Aottens/PTZ-DriverBoard/hardware/fab/jlc_pins.md

| LCSC | Part | First reference | JLC's pin: name -> net on the board |
| --- | --- | --- | --- |
| C7171 | 10 µF 16 V | C111 | 1: 1 -> +3V3, 2: 2 -> GND |
| C19077573 | SMBJ18A | D101 | 1: C -> VM, 2: A -> GND |
| C8678 | SS34 | D102 | 1: K -> +5V, 2: A -> +5V_REG |
| C8598 | B5819W | D201 | 1: - -> EN, 2: + -> PERIPH_RST_N |
| C2500 | BAV99 | D302 | 1: 1 -> GND, 2: 2 -> +3V3, 3: 3 -> HOME1 |
| C400894 | AOD4185 | Q101 | 1: G -> RP_GATE, 2: D -> VIN_RAW, 3: S -> VIN |
| C20917 | AO3400A | Q801 | 1: G -> FAN_G, 2: S -> GND, 3: D -> FAN_N |
| C2892547 | NTC 10k | RT801 | 1: 1 -> NTC_SENSE, 2: 2 -> GND |
| C6186 | AMS1117-3.3 | U102 | 1: GND -> GND, 2: VOUT -> +3V3, 3: VIN -> +5V, 4: VOUT -> not connected |
| C7420376 | SRV05-4 | U301 | 1: 1 -> SNS1_SDA, 2: 2 -> GND, 3: 3 -> SNS1_SCL, 4: 4 -> unconnected-(U301-IO3-Pad4), 5: 5 -> V_SNS, 6: 6 -> unconnected-(U301-IO4-Pad6) |
| C130026 | TCA9548A | U701 | 1: A0 -> GND, 2: A1 -> GND, 3: RESET# -> PERIPH_RST_N, 4: SD0 -> MUX1_SDA, 5: SC0 -> MUX1_SCL, 6: SD1 -> MUX2_SDA, 7: SC1 -> MUX2_SCL, 8: SD2 -> MUX3_SDA, 9: SC2 -> MUX3_SCL, 10: SD3 -> MUX4_SDA, 11: SC3 -> MUX4_SCL, 12: GND -> GND, 13: SD4 -> MUX5_SDA, 14: SC4 -> MUX5_SCL, 15: SD5 -> unconnected-(U701-SD5-Pad15), 16: SC5 -> unconnected-(U701-SC5-Pad16), 17: SD6 -> unconnected-(U701-SD6-Pad17), 18: SC6 -> unconnected-(U701-SC6-Pad18), 19: SD7 -> unconnected-(U701-SD7-Pad19), 20: SC7 -> unconnected-(U701-SC7-Pad20), 21: A2 -> GND, 22: SCL -> I2C_SCL, 23: SDA -> I2C_SDA, 24: VCC -> +3V3 |
