Aottens/PTZ-DriverBoard/DECISIONS.md

# PTZ driver board — Decision Log

Append-only. Newest at top. Each entry: date, decision, alternatives, why, reversal trigger.

---

## 2026-11-12 — Rev B: what was done with the third blind review

The board was routed again after the second review, so a fresh reviewer saw the board as it is ordered
(`hardware/review/BLIND_REVIEW_3.md`). Verdict: order. No KRITIEK finding, one BELANGRIJK, nine KLEIN; nothing on
the board or in the JLC files changes. Six findings repeat ones accepted on 2026-11-11 (the RJ45 jack and the
wall, the height above the heat sinks, the headroom of `+3V3`, the shared reset, the three rails without a test
point, the DevKit version). Two are new and accepted:
- **SLEEPN of the TMC2240 above VS + 0.3 V on USB alone (K6).** The BIGTREETECH module ties SLEEPN to VCC_IO
  through 4.7 kΩ, and the board gives the modules 3.3 V on USB while `VM` is off. The calculation: at most
  (3.3 − 0.6) V / 4.7 kΩ = 0.6 mA into the pin per module. The limit is the module maker's to keep and the
  resistor bounds the current; the board cannot change it without giving up logic on USB, which POW-05 asks.
  What follows for firmware: four modules can feed `VM` about 2.3 mA against the 110 kΩ of the sense divider,
  so `VM` may read up to about 2.7 V with no supply. Bring-up 7.9 measures it.
- **No TVS array on the home inputs (K8).** 10 kΩ in series and a BAV99 to ground and `+3V3` keep the MCU pin
  within its limits with 17 V on the wire (1.3 mA, by calculation), which is what ENC-03 asks. A hard discharge
  lands on a 0603 resistor.
One finding is answered by calculation: the reviewer suspected that JLC's placement point of an asymmetric part
differs from the point in the CPL (K5). `make_jlc.py` writes the origin of JLC's own footprint, and for the
TO-252, both SOT-223 and the SOT-23 parts that origin is the middle of JLC's pads, within 0.1 mm of the middle of
ours. The preview stays the check.
*Alternatives:* a diode from `VM` to each socket's SLEEPN, which is not on the StepStick pins; a spare channel of
each SRV05-4 on the home input, which is a board change and a new routing for a part the spec does not ask.
*Reversal trigger:* bring-up 7.9 reads `VM` above 3 V on USB alone, or a home input fails after a discharge:
then the next revision takes the SRV05-4's spare channels, or a GPIO on the reset line (K3).

## 2026-11-11 — Rev B: the loose parts come from Reichelt, and the regulator is the Traco again

The owner's LCSC cart showed about €22 of import charges on the $22.51 of loose parts. Since 1 July 2026 a parcel
up to €150 from outside the EU pays €3 of duty per kind of product (LCSC counts its first-level categories), with
handling on top; the quantity does not count, the number of kinds does. So the list moves inside the EU.
Reichelt has 17 of its lines, read on its Dutch pages: genuine JST headers, housings and contacts for VH, XH and
PH, Littelfuse TR5 fuses and holders, the capacitors, a pin header and the Traco TSR 1-2450, together €22.25 with
VAT and €6.95 for DPD. The socket strips come as four female headers 1×40 with the modules from TinyTronics.
This overturns the entry below, of the same day: its reason was DigiKey's €18 of shipping for one regulator, and
at Reichelt the Traco (€6.97) comes with the rest.
*Alternatives:* LCSC, cheaper per part but about €25 of goods with VAT, shipping and the €22; TME, whose product
pages could not be read (shipping €7.14); TinyTronics alone, which has no VH connector, no TR5 fuse and no 1 A
regulator in this form.
*What is given up:* a stock check by script, since Reichelt's pages refuse one. The supply connector is the
B2P-VH-B, the same header in PBT: KiCad's footprints for the two have the same pads.
*Also changed:* the estimate of the JLC order counts the same charge, €5 to €10, and is now €68 to €90.
*Reversal trigger:* the charge goes, or an order grows so large that LCSC's prices outweigh it.

---

## 2026-11-11 — Rev B: the 5 V regulator on the shopping list is YLPTEC's K7805-1000R3

The owner asked which shop is cheapest for the loose parts. The parts cost little everywhere; what counts is the
number of parcels. The Traco TSR 1-2450 was the only reason for a DigiKey order: €5.57 + VAT, and €18 shipping
below €50. LCSC had no Traco, but 11 005 of YLPTEC's K7805-1000R3 (C2992391) at $2.38, which rides in the LCSC
order the owner places anyway. Its data sheet (V1.00, 06/2013, listed in `hardware/datasheets/README.md`) gives pins 1 = in,
2 = ground, 3 = out, 8 to 36 V in, 1 A, 680 µF of capacitive load and a body of 11.5 × 7.55 × 10.2 mm: what POW-07
and the footprint ask. The list orders two, one as a spare.
*Alternatives:* the Traco at Reichelt (€7.22) or RS (€7.08), each a parcel of its own with shipping that was not
found on an official page; TinyTronics' Hi-Link K7805-500R3, which gives 0.5 A where the budget is 0.9 A.
*What is given up:* a certified maker. The sheet is three pages, with no absolute maximum input voltage, no
start-up behaviour and no word on back-feed (D102 covers that) or over-temperature. Nothing is measured.
*Reversal trigger:* the 5 V rail fails section 1 of `tests/hardware/bringup-rev-b.md`, or dips when the modules go
in; then a Traco TSR 1-2450 or a Mornsun K7805-1000R3 goes into the same holes.

---

## 2026-11-11 — Rev B: what was done with the blind review

The first review is `hardware/review/BLIND_REVIEW.md`: no KRITIEK finding, three BELANGRIJK, all three fixed.
`hardware/review/HANDLED.md` lists every finding, the small ones too, and the second review of the changed board.

**B1, parts under the soldered-in Ethernet module: fixed.** Nothing stands under it now; `check_board.py` checks it.

**B2, the fan output on VM was not short-proof: fixed by taking the option away.** The fan output is 5 V only. A
fan for the supply voltage would need a fuse of its own, and the PRD asks for one fan output, not for two voltages.
*Reversal trigger:* a 5 V fan cannot cool the four drivers on the rig; then a later revision gets a fused 12 V output.

**B3, the 5 V module and what it must charge: fixed, and the choice of module narrowed.** The board's own
capacitance on the logic rails went from about 320 µF to 113 µF; with the plugged-in modules the estimate is about
230 µF. The Traco TSR 1-2450 (470 µF) and the Mornsun K7805-1000R3 (680 µF) take that; the RECOM R-78E5.0-1.0
(220 µF) does not and is ruled out in the spec, in `ASSEMBLY.md` and on the silkscreen. The AMS1117 regulators keep
30 µF of tantalum at their outputs, above the 22 µF their data sheet asks for.

**The second review, of the board after those fixes** (`BLIND_REVIEW_2.md`): no KRITIEK, three BELANGRIJK.
- *B1, the ground of the motor half hung on 4 mm of copper: fixed.* The signals between the MCU module and the
  sockets cut both pours across the board. Ground is now laid as tracks before routing, on the bottom: a spine
  north of the MCU module's pin row from that module's ground pins to the supply connector, and four bridges north
  to ground pins of the sockets. `tools/groundcut.py` gives 14.0 mm of copper to the supply connector and 10.0 mm
  to the MCU module, from 4.2 mm for both; BRD-13 asks 8 and `check_board.py` checks it. It is a measure of
  geometry, not of noise: whether SPI is clean beside running motors is bring-up step 7.6.
- *B2, no surge clamp on the logic branch with the motor fuse out: fixed.* A second SMBJ18A (D103) on `VIN_L`, and
  the gate divider at half the input instead of 0.6. *Alternative:* moving the one TVS in front of both fuses, which
  leaves a failed TVS without a fuse.
- *B3, 26 to 32 mm between the Ethernet jack and the wall: accepted.* The head does not exist; the base gets a hole
  in line with the jack or a coupler in the wall with a short lead (`hardware/ASSEMBLY.md`, RB-05). Turning the
  module a quarter would point the jack at the pan motor or at the drivers. *Reversal trigger:* the base's CAD
  model cannot give either.
The board changed after this second review and has had no third one: ERC, DRC, the netlist check and the ground
measurement are what cover those last changes.

**Accepted small findings, with the reason:**
- *K1, `+3V3` has about 1.25 V above the regulator where its data sheet asks 1.3 V at 0.8 A.* The load is 0.17 A,
  where the drop-out is about 1.1 V; the calculation leaves it in regulation. Bring-up steps 1.3, 3.2 and 6.1 measure
  it. *Reversal trigger:* `+3V3` under 3.2 V with the Ethernet module sending; then D102 becomes a part with a lower
  drop, or U102 a regulator with a lower drop-out in the same package.
- *K3, the TMC2240's DIAG0 is open drain by default.* Firmware sets `diag0_pushpull`; DRV-05 and bring-up 7.3 say so.
- *K6, no reset of the multiplexer apart from the MCU's.* No pin is left; firmware can clock a stuck sensor free.
- *K8, ground pins sit solid in the copper.* Thermal spokes left pins on a single spoke on this two-layer board;
  the owner solders with a second more heat.
- *K9 to K12, fit and edge distances:* stated in `ASSEMBLY.md` and in the pull request's flags.
- *K14, a shorted sensor cable restarts the MCU for as long as the short lasts.* Nothing is damaged, which is what
  POW-03 asks. A resettable fuse per port would be a fourth and fifth Extended line. *Reversal trigger:* a sensor
  cable that shorts in use.

---

## 2026-11-11 — Rev B: what the one-run build decided

Made by the Rev B build session (RB-02) inside the approved PRD; the owner sees them in the pull request. Each can
be undone on a next revision; none changes a requirement.

**The 5 V regulator, the two fuses and the four bulk capacitors are through-hole parts the owner solders.** JLC's
fee-free libraries (351 Basic, about 1 200 Preferred) hold no power inductor, fuse, electrolytic capacitor,
thermistor or P-channel power FET. A buck converter on the board would have been a fourth Extended line with a
layout nobody can measure in this build; a three-pin 5 V switching module in the 7805 pin order is certified by
its maker and is bought once instead of five times. *Alternative:* the XL1509 the PRD's part check names, with an
Extended inductor. *Reversal trigger:* the owner wants nothing to solder but connectors; then the buck comes back
at about €5 more per order.

**Three Extended lines, at the PRD's limit:** the I2C multiplexer, the reverse-polarity FET (AOD4185) and the
thermistor. Three small fee-free FETs in parallel were the first plan for reverse polarity; the calculation in
`hardware/calc/power.py` shows they do not survive the current a 5 A time-lag fuse lets through.

**The drivers and the Ethernet module share one SPI bus; every usable MCU pin is in use.** The N8 DevKitC the PRD
prefers is end of life at Espressif, and the N16R8 that shops sell needs GPIO35 to 37 for its memory. Without
those, without the pins of the module's own LED, USB and BOOT button, 28 pins are left, and 28 signals need one. A
bus of its own for Ethernet would have taken three more. So: one bus; a select line per driver socket, which is
also that socket's one-wire UART line when a TMC2209 is plugged in; three solder jumpers per socket that take a
TMC2209's MS1, MS2 and second UART pin off the bus; one shared stall and fault line through diodes (PRD DRV-04,
*proposal*); the multiplexer and the Ethernet module reset from the MCU's own reset line through a diode, because
no pin is left for it. *Reversal trigger:* firmware needs a spare pin, or Ethernet traffic disturbs the drivers on
the rig; then a later revision takes an I/O expander for the home inputs.

**The sensor ports have their own 3.3 V regulator, an ESD array each, and a jumper to 5 V.** A short on a sensor
cable then leaves the logic supply alone. The regulator is a second AMS1117, not a small 200 mA part: that one
limits a short to 100 mA but has no thermal shutdown, and 0.46 W in a SOT-23 is twice its rating. The home inputs
have a resistor and clamp instead of an ESD array, so they also survive a steady 17 V from a motor wire.

**The board is 100 × 80 mm on two layers, and the Ethernet module is soldered in.** That is the size the envelope
allows and JLC's cheapest size class. On ordinary sockets the Ethernet jack would stand 28 mm above the board,
over the 25 mm the envelope gives. The driver modules, on sockets with a 12 mm heat sink, reach 24.6 mm by
calculation: the base's height is the tightest number in the fit check, and the heat sink's height is an assumption.

**With USB plugged in while the supply is on, USB and the board's regulator share the logic load.** Both reach
`+5V` through a Schottky diode, so the higher of the two feeds it: a USB port may then see up to about 0.65 A, or
0.85 A with the fan running. Moving the fan to the regulator's side of its diode was not worth a new track
across the board. *Reversal trigger:* a USB port that cuts out during bench work with the supply on.

---

## 2026-11-11 — Rev B's PRD is approved; homing comes from the encoders

**Decision (owner, in chat):** The Rev B hardware and cost sections of `specs/PRD.md` are approved as written, the lines marked *(proposal)* included (gate 1). Pan and tilt need no homing move: their absolute encoders give the position at boot (FW-03). Zoom may home by stall against the ring's end, and a home input per axis stays as a fallback (ENC-03). How close a preset lands after a restart is measured on the rig (ENC-06, R-T2). Rev B is built by one Fable 5.2 session from `docs/prompts/fable-board-rev-b.md`, reusing the tools Rev A's session built.

**Alternatives considered:** stall homing on every axis, which by recollection is at best about one full step repeatable (0.24° at 7.5:1, against 0.005° in TGT-05) and runs the head into a stop in front of an audience; a home switch on every axis.

**Reasoning:** no move at power-up suits a theatre, and the encoders are on the board anyway. The open risk is the encoder's repeatability after a restart: one count is 0.088° on the AS5600 and 0.022° on the MT6701, and how far averaging helps depends on noise, which only the rig shows.

**Reversal trigger:** R-T2 shows presets after a restart landing too far off with either sensor; then pan and tilt get a hall sensor on the home input as a fine reference.

---

## 2026-11-11 — Rev A is not ordered; Rev B uses plug-in modules on a cheap board

**Decision (owner, in chat):** Rev A is not ordered: the JLC quote came to almost €400 for five boards, too much for a hobby project. Rev B carries plug-in modules on a cheap board: four StepStick-format drivers (TMC2240 by default), an ESP32-S3-DevKitC-1U with its U.FL antenna led out to an SMA in the wall, a W5500 module with its own RJ45, and four I2C sensor ports behind a multiplexer for AS5600 or MT6701 boards. RS-485, CAN and the tally outputs are struck; Pelco-D and VISCA run over the network, Art-Net and sACN replace DMX. The fan output stays. The input takes 11 to 17 V, for a 12 V supply or D-Tap. One JLC order of five boards costs at most €100 (COST-01), with Basic parts wherever one does the job. This replaces the ESP32-C6-MINI-1U decision of 2026-11-10: the C6 drives only two steppers with hardware-generated steps, the S3 four.

**Alternatives considered:** ordering Rev A; trimming Rev A (dropping CAN and RS-485 leaves the four TMC5240 drivers and most of the 42 Extended lines, which drove the price); the owner's Waveshare ESP32-C6 board; a W5500 directly on the board, which brings two Extended parts and the crystal layout the Rev A review worried about; keeping I2C sensors off a multiplexer, which fails because the AS5600 has one fixed address.

**Reasoning:** the price was never a requirement, so Rev A grew without a brake. Plug-in modules move the expensive and hard parts off the JLC order, let the owner reuse the TMC2209 modules already in hand, and let each part be swapped without a new board. The estimate in `docs/research/rev-b-cost.md` comes to about €58 to €92 for the JLC order.

**Reversal trigger:** the estimate redone before the order goes over €100; the rig shows I2C cannot carry the tilt sensor's cable (R-T2); or four axes with steps from the S3 are not smooth enough on the rig.

---

## 2026-11-11 — Rev A: what was done with the blind review

The review is `hardware/review/BLIND_REVIEW.md`: no KRITIEK finding, five BELANGRIJK. `hardware/review/HANDLED.md` lists every finding, the small ones too.

**B1, the 3.3 V output on one 0.2 mm track and one via: fixed.** Six vias and 0.5 mm tracks now. Checked on the board: `+3V3` vias at L102.2, C112.1 and C113.1, track widths 0.5 mm.

**B2, the W5500 crystal tracks: partly fixed, the rest accepted.** `ETH_XI`, the oscillator's input, now runs on the top layer only, 2.4 mm from pin 30 to the crystal and 3.7 mm on to R802 and C810. A `+3V3` track that ran between the crystal's pads is gone. `ETH_XO`, the driven end, is down from about 36 mm and five vias to about 22 mm and three, and no longer passes the 5 V regulator. A shorter way does not exist without moving parts: pin 31 is shut in on the top layer between the tracks of pins 30 and 33, and the inner layer and the bottom under the crystal carry the SPI and chip-select lines.
*Why accepted:* the calculation gives about 3 pF of extra capacitance on XO (three vias at 0.4 pF, 11.5 mm on inner layer 2, 6 mm on the bottom, 4 mm on top), which moves the load the crystal sees from 12 pF to between 11 and 12.5 pF: under 15 ppm of pull at the usual 10 to 15 ppm/pF, against the 50 ppm Ethernet allows. XO is the low-impedance end of the oscillator; the sensitive end is the short one.
*Reversal trigger:* the link does not come up or drops packets in bring-up step 7.1b. Then Rev B turns the crystal a quarter and puts it beside pins 30 and 31.

**B3, the TVS D102 has no JLC footprint to check its rotation against: accepted with two checks.** The placement file carries KiCad's own angle for it. KiCad's `D_SMB` has pad 1 as the cathode; how JLC's library draws this part is not known, so the angle is not verified. It is the first line of the JLC preview checklist in the pull request, and bring-up step 0.3b measures the diode's direction before any supply is connected. A reversed TVS costs turning one SMB part by hand.
*Reversal trigger:* none; a later revision takes a part number that JLC's library knows.

**B4, the sensor ports only suit SPI with the clock resting low: accepted as a stated limit.** One pin both enables the buffer and selects the sensor, so a clock that rests high rises at the port as chip select falls. `specs/modules/sensing.md` ENC-05 now says so, and the bring-up checklist has step 5.2b. The reviewer names AS5047 and AS5048A as sensors with the clock resting low, and MT6835 as one with the clock resting high. *Alternatives:* a pull-up footprint per port or a separate enable pin; both need a pin or parts the board has no room for at this stage, and no sensor has been chosen that needs them.
*Reversal trigger:* the rig (R-T2) chooses a sensor that needs the clock high at rest and does not accept mode 0 timing. Then Rev B gives the buffer its own enable.

**B5, four axes at 1.5 A RMS continuously run hot: accepted, as `calc/thermal.py` already said.** The reviewer's own calculation comes to a junction at 100 to 125 °C in a closed base. The board has nine vias under each driver, a bare copper window under each for a heat bar, a fan output, and standstill current reduction is a firmware setting. Bring-up steps 4.4 and 4.8 read the temperatures before the board goes into the base.
*Reversal trigger:* step 4.8 shows a driver over 100 °C at the currents the head really uses, with the heat bar fitted.
---

## 2026-11-10 — Rev A: the board grows to 100 × 80 mm

**Decision (owner, in chat):** The board may be 100 × 80 mm instead of 85 × 65 mm. It lies in the base, not in the head, where the first size came from. The RJ45 jack and the supply inlet sit in the base wall. The four M3 holes stay 4 mm from the edges in each corner.

**Alternatives considered:** staying at 85 × 65 mm with a router that pushes tracks aside and a redesigned driver cell (tried: 39 to 62 connections stayed open in six routing runs); six layers on the old size; dropping CAN (about 2 % of the area, and not where the congestion was).

**Why:** On 85 × 65 mm the parts' courtyards filled 73 % of the board, top side only, with two signal layers. On 100 × 80 mm they fill 50 %. The calculation from the brief's envelope (base 160 mm inside, motor 42 × 42 mm at 55.7 mm, board 1 mm from the motor) leaves 19.7 mm from the corners beside the motor to the wall and 11.9 mm from the far corners; the middle of each free edge has about 30 mm.

**Reversal trigger:** something along the base wall (screw bosses, the bearing seat, the jacks in the wall) needs more than the room the corners leave; then the far corners are cut off at an angle before the board shrinks.

---

## 2026-11-10 — Rev A: the Ethernet jack is off the board

**Decision:** The W5500 and all of its circuit stay on the board, but the RJ45 jack does not: J801 is a 7-pin header for a short lead to a jack with magnetics in the housing wall. The CAN connector stays.

**Alternatives considered:** the HR911105A on the board, as the brief asked first; a transformer on the board with a 4-wire header behind it; dropping CAN as well.

**Reasoning:** counted by courtyard area, everything on 85 x 65 mm with parts on one side came to about 76 % of the area where parts can go, which leaves no room to route. The brief names the jack as the first thing to go (CTL-03). The header costs a tenth of the jack's area. A transformer on the board would have been the cleaner electrical cut, but its pin order could not be checked against a maker's sheet in this run.

**Reversal trigger:** a later revision gets a larger outline or parts on both sides; then the jack returns to the board.

---

## 2026-11-10 — Rev A: one chip select per driver and per sensor, no daisy chain

**Decision:** The four drivers and four sensor ports each have their own chip select from a dual 2-to-4 decoder (two address lines, two strobes). The drivers are not daisy-chained.

**Alternatives considered:** the TMC5240 daisy chain with one chip select, which `docs/research/README.md` called possibly the best part; a 4-to-16 decoder that also selects the W5500.

**Reasoning:** a chain makes every access four times as long and lets one dead driver take the other three off the bus, on a prototype whose job is to be measured. Four separate writes at 4 MHz start four axes within about 40 microseconds of each other, by calculation (4 x 40 bits), which a camera head cannot show. Two strobes keep the decoder free of glitches when the address changes. The W5500 keeps a plain chip select, because Espressif's driver expects one.

**Reversal trigger:** the rig shows that axes must start within microseconds; then the chain is a board change, not a firmware one.

---

## 2026-11-10 — Rev A: slow signals on an I/O expander, the stop on direct pins

**Decision:** The ESP32-C6's 22 pins carry the SPI bus, chip selects, I2C, RS-485, CAN, USB, the fan, the supply reading, the boot button, and the two signals that stop motors: `DRV_ENN` and the expander's interrupt. DIAG0 and DIAG1 of all axes, the Ethernet interrupt and reset, the status LED and the camera outputs are on a PCAL6416A. No pin is spare.

**Alternatives considered:** DIAG wired together on one direct pin, which fails when one axis uses DIAG0 as a step output; an expander without an interrupt mask, which would flood the MCU with interrupts in that case.

**Reasoning:** the driver stops its own motor on a stall or a home switch, in the chip. What the MCU needs fast is a way to cut power, and that is `DRV_ENN` on a direct pin, pulled up so the bridges are off at reset. The same pin gates the buffer of the external driver ports, so it stops those too.

**Reversal trigger:** firmware needs a DIAG edge faster than an I2C read, about 0.1 ms.

---

## 2026-11-10 — Rev A: sensor ports on their own buffered bus, 3.3 V only

**Decision:** Each sensor port gets its own buffered clock and data-out, switched on only while a sensor is selected, and its data-in passes a buffer that opens only for that port. The ports are 3.3 V only. The home input shares the 7-pin connector.

**Alternatives considered:** the sensor cable directly on the bus that the drivers and Ethernet share; a solder jumper for 5 V sensors.

**Reasoning:** the brief asks to keep the long cable from loading the shared bus. Buffers do that, and gating them keeps Ethernet's clock edges out of a cable that runs beside motor wires. A 5 V option would need 5 V signal levels as well: a 3.3 V clock does not reach a 5 V sensor's input-high level.

**Reversal trigger:** R-T2 chooses a sensor that needs 5 V or another bus.

---

## 2026-11-10 — Rev A: the board alone carries about 1 A per axis continuously

**Decision:** The board gets nine vias and a bare ground window on the bottom under each driver, the fan output and temperature readings. It is not claimed to carry 1.5 A on all four axes in still air.

**Alternatives considered:** a larger board; a dedicated heat-sink footprint; leaving it to the datasheet's 2.1 A figure.

**Reasoning:** `hardware/calc/thermal.py` puts four axes at 1.5 A at about 120 C board temperature in still air, past what a printed housing and the chip allow; about 1.0 A on four axes, or 1.35 A on two, is the limit. The earlier estimate in `docs/research/README.md` counted the drivers only, cold, on a board with nothing else on it. With a metal bar on the windows or moving air the same calculation allows 1.5 A and more. Nothing here is measured.

**Reversal trigger:** the bring-up run (step 4.4 and 4.8) shows the calculation is far off, either way.

---

## 2026-11-10 — Rev A: smaller choices made in layout

**Decision:**
- Motor connector pins are A1, A2, B2, B1: coil B mirrored, because that is the order the driver's pins leave the chip.
- Motor, sensor, CAN and fan connectors are top entry and may stand inside the board; side-entry connectors are on the three free edges.
- No reset button: the chip resets over USB. A test point on EN remains.
- No ESD capacitors on the motor outputs: they did not fit. The motor housings must be grounded instead.
- Fuses are soldered, not in holders.
- The two bulk capacitors are ordinary aluminium electrolytics on purpose: their resistance damps a hot-plug.

**Alternatives considered:** each of these the other way round; see `specs/modules/` and `hardware/BUILD_NOTES.md`.

**Reasoning:** space on 85 x 65 mm with parts on one side, and tracks that do not cross.

**Reversal trigger:** an ESD reset on the rig brings the output capacitors back first.

---

## 2026-11-10 — Rev A is designed in one run by Fable 5.2, before the rig results

**Decision:** One Fable 5.2 session takes Rev A from requirements to files ready to order, from `docs/prompts/fable-board-rev-a.md`, without waiting for the rig. It uses the leading candidates, at most 85×65 mm, JLC Economic PCBA, a W5500 with RJ45, and two open-drain camera outputs. Gate 1 for this build is the owner's approval of that prompt. The order gate is unchanged, and only the owner orders.

**Alternatives considered:** waiting for the rig results; building in several reviewed slices as `BACKLOG.md` planned.

**Reasoning:** the owner wants one board that can do everything and wants to test this model on a task of this size. A prototype costs little next to weeks of slices. It can also replace the breakout boards on the rig.

**Risk accepted:** the rig can still overturn the motor, driver, sensor or voltage choice, or show that the sensor cable needs another design (R-T1, R-T2). Then Rev A is partly thrown away. The board is checked by calculation and review only until the owner's bring-up run.

**Reversal trigger:** the blind review finds the approach unsound, or the rig shows a part choice fails before the order is placed.

---

## 2026-11-10 — The MCU for Rev A is the ESP32-C6-MINI-1U

**Decision:** Rev A uses the ESP32-C6-MINI-1U-H4 (LCSC C20627095), assembled by JLC with Economic PCBA. This replaces the ESP32-S3-MINI-1U as the design basis. The owner chose it.

**Alternatives considered:** an ESP32-S3-WROOM-1U soldered by hand on an otherwise JLC-assembled board, which has the most pins and two cores; a bare ESP32-S3FN8, which needs our own RF section, tuned with a network analyser, and 0201 parts that Economic cannot place; an RP2350B with a separate radio and second firmware; Standard PCBA, whose 70 mm minimum size excludes a 65 mm wide board without a panel.

**Reasoning:** one "Standard Only" part moves the whole order to Standard, and JLC lists the ESP32-S3 modules that way. The C6 module keeps the radio in a finished module. The TMC5240 generates the motion, so the MCU has less to do. The price is 22 GPIOs for about 27 signals, one user SPI bus and one core, so the board needs an I2C expander and a chip-select decoder and has almost no spare pins.

**Reversal trigger:** the pin plan does not close, one core cannot hold the control and sensor loop on the rig, or JLC changes a part's PCBA type.

---

## 2026-11-09 — Working rules for board design, from Anthropic's electronics work

**Decision:** Schematic and layout go to the strongest model available instead of Sonnet. Added to `CLAUDE.md`: route the hard nets first, a layout may overturn the pin table, check the board in its housing by code, sort every manufacturability and sourcing flag. The owner approved this.

**Alternatives considered:** keeping Sonnet for all building; waiting with these rules until the board starts.

**Reasoning:** [Anthropic's write-up with Diode Computers](https://www.anthropic.com/research/claude-electronics-design) reports a benchmark for placement and rerouting going from 25 % to 69 % between two model generations, and describes these habits. Diode has a commercial relationship with Anthropic, and the prototypes were not electrically validated, so this is a working habit and not proof.

**Reversal trigger:** a Sonnet layout holds up against the blind review, or the rules slow the work without catching defects.

---

## 2026-11-04 — The base is at most Ø165 mm

**Decision:** The head's base is at most Ø165 mm. The motor sits under the pulley, so the centres are at most 55.7 mm. The rig keeps to that and compares 6.25:1 without idlers against 7.5:1 with two idlers. This replaces the 9:1 and 12.5:1 rig in the entry below.

**Alternatives considered:** 12.5:1 with a 200T (Ø196 with idlers, about Ø300 without); 9:1 with a 144T, which reaches the limit with no margin.

**Reasoning:** the owner rejected the size of a 200T and a 400 mm belt, and small is a stated goal. Claude had let tooth grip set the layout. A rig with the head's real geometry also tests the right question.

**Reversal trigger:** the rig shows neither ratio is acceptable; then the capstan (IDEA-04) comes first, within the same base.

---

## 2026-11-04 — One belt stage, no double belt

**Decision:** The head uses one belt stage per axis. The rig compares 9:1 and 12.5:1, with 26 and 42 Ncm motors. This replaces the 30:1 two-stage layout and the 17 Ncm motor in the rig entry below.

**Alternatives considered:** 30:1 in two stages; a capstan drive (IDEA-04); gearboxes, worm gears and harmonic drives, set aside for backlash, noise or price.

**Reasoning:** the owner does not want a double belt. Claude's case for 30:1 counted absolute stepper error, while a preset landing from the same side mostly repeats it. The remaining risk is a slow wave at very low speed, which the rig measures.

**Reversal trigger:** the wave stays visible at 12.5:1 even with a tuned microstep table; then a capstan comes first, before a second belt.

---

## 2026-11-04 — The rig spec is approved

**Decision:** `specs/modules/rig.md` is approved (gate 1), with the 17HE08-1004S and 17HE12-1204S motors instead of the 0.4 A motor from the July design.

**Alternatives considered:** the 17HS13-0404S1, which needs 35 V at 300 rpm at rated current by calculation.

**Reasoning:** low-resistance motors reach the speed on 12 V and are thinner, which suits a small base.

**Reversal trigger:** R-T1 shows these motors are too weak or too loud.

---

## 2026-11-04 — Targets approved, G7 first, and the rig goes ahead

**Decision:** TGT-01..05 are approved. The first camera is a Panasonic G7 with a 14-140 mm, Micro Four Thirds. A one-axis test rig goes ahead.

**Alternatives considered:** designing the board first and measuring on it.

**Reasoning:** at 140 mm on this sensor a pixel is smaller than the 200 mm assumed so far, so exactness gets harder. The rig tests motor, reduction, voltage and cable before an order that costs weeks.

**Reversal trigger:** the rig shows the targets are out of reach within DIY means; then the targets go back to the owner.

---

## 2026-11-04 — The fan output stays, as an option

**Decision:** Keep a switched PWM output for a fan (AUX-03), off by default. This corrects "No fan" in the entry below: the head is still designed to meet its targets without one.

**Alternatives considered:** striking the output, to save a pin and some board space.

**Reasoning:** the owner wants the option. It costs one pin and a small switch, and it is a reserve if the heat calculation proves optimistic.

**Reversal trigger:** it turns out to be the part that keeps the board from getting smaller.

---

## 2026-11-04 — Theatre use sets the bar, and the old head is out

**Decision:** The head carries a DSLR or mirrorless up to 2 kg, in theatres among the audience, as exact as DIY allows. No LANC, since the camera has none. No fan. The old head is left out, so
the evidence comes from a new one-axis test rig. Targets TGT-01..05 are proposed, from a professional head, for the owner to approve.

**Alternatives considered:** measuring the old head as a baseline; keeping LANC for other cameras (the board is for one head and should be small).

**Reasoning:** the owner does not know the speeds yet, so a reference gives something to change. A rig answers noise, smoothness, reduction and cable questions on real hardware before any board is ordered.

**Reversal trigger:** another camera with LANC comes into use; then CAM-01 returns.

---

## 2026-11-04 — One head, small, a research phase first

**Decision:** The board is for one head, the owner's own, and as small as possible. Four axes. Limited pan with a cable loop, no
slip ring. RS-232 is dropped, so VISCA only runs over IP. ESP32-S3 and TMC2209 go back to being candidates, and a joint research phase
comes before the hardware is fixed. The new 3D head does not exist yet, and Claude helps design it.

**Alternatives considered:** fixing the proposed parts directly, as in the first PRD draft.

**Reasoning:** the owner named those parts as examples and wants to look for better solutions together. One head means CE and series cost
do not steer the choices, so a dearer driver can win if it makes the board smaller.

**Reversal trigger:** selling it after all; then this entry and the out-of-scope list get reopened.

---

## 2026-11-04 — A new hardware and software pair, as one driver board for all heads

**Decision:** Start over on both board and firmware, in this repo. The board carries its stepper drivers in SMD and is
meant to drive any PTZ head. The owner's words: a driver board for PTZ heads that can do everything.

**Alternatives considered:** upgrading the existing head with encoders (April brief); the custom board for one 3D head
with SERVO42C drives (July design).

**Reasoning:** the owner wants one print that does not depend on the mechanics, and has the freedom to redesign the 3D
head alongside it. With JLC assembly and the KiCad flow from the scoreboard, SMD drivers are within reach.

**Reversal trigger:** "everything" does not fit a board or budget; then ports drop, per the OPEN lines in the PRD.

---

## 2026-11-04 — Scoreboard flow for KiCad, CMDMX and Kikkuh harness for the work

**Decision:** Take the KiCad tooling and blind review from `RunningScoreboard`, and the spec → test → build → review
loop with its tracking from `ColourmotionDMX` and `Kikkuh`. Not the separate `Harnas` project, which neither uses.

**Alternatives considered:** EasyEDA, as in the April brief.

**Reasoning:** the owner's experience with this KiCad flow was good, and the check of a schematic against a spec fits
the same loop as a test against code.

**Reversal trigger:** the loop slows hardware work down without catching defects.
