Aottens/PTZ-DriverBoard/hardware/fab/render_bottom.png

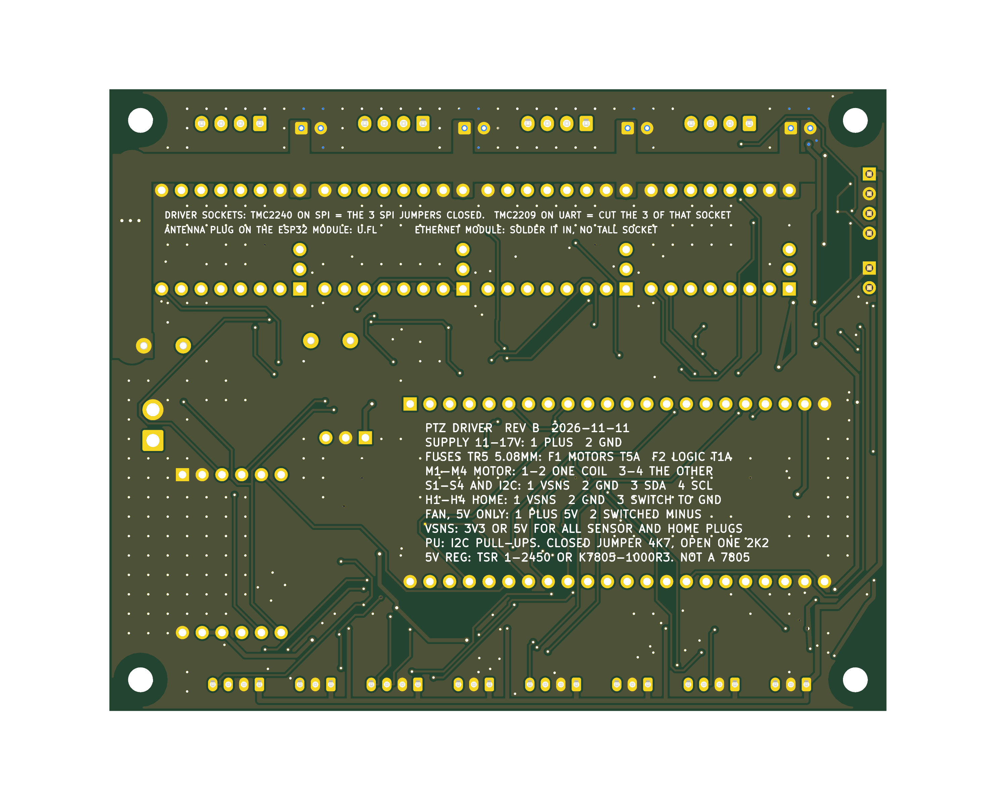
hardware/fab/render_bottom.png
