Aottens/PTZ-DriverBoard/hardware/fab/render_top.png

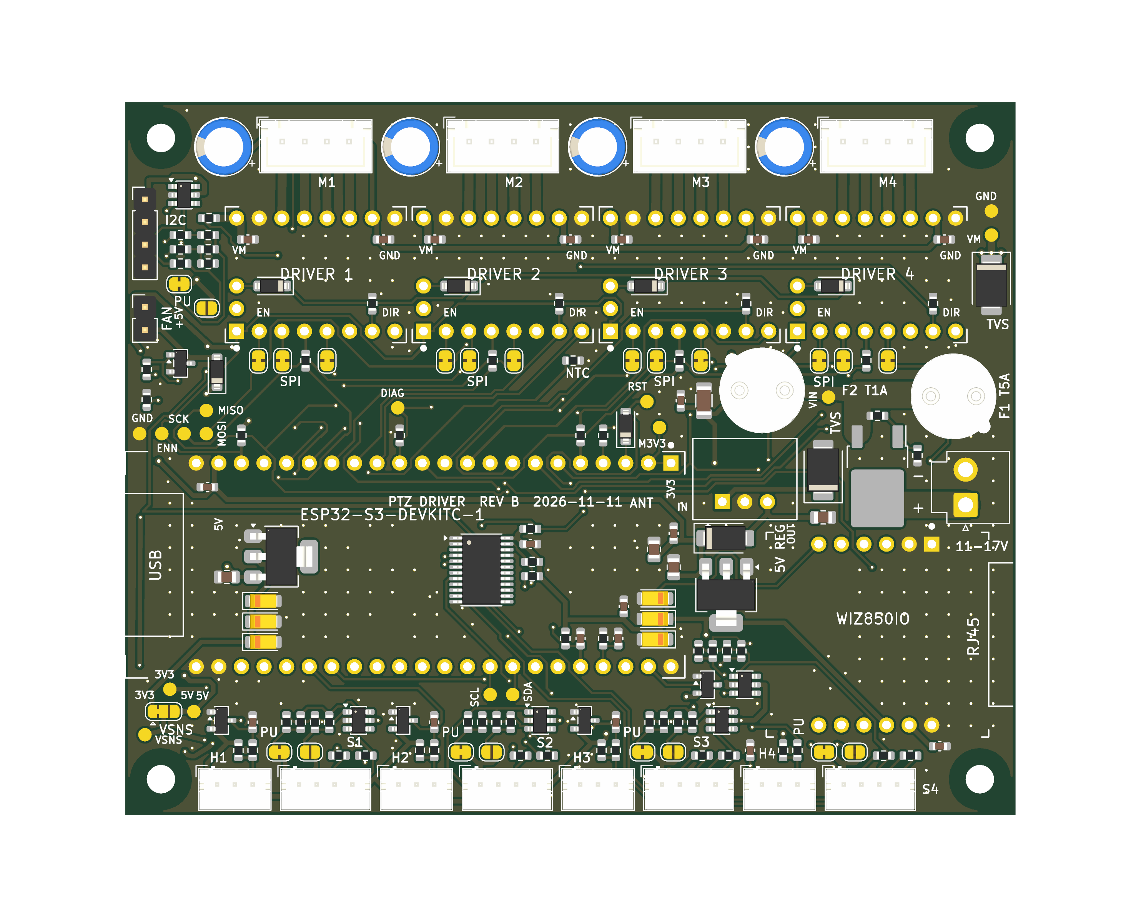
hardware/fab/render_top.png
