Aottens/PTZ-DriverBoard/hardware/sourcing/planned_bom.csv

LCSC | Qty | Pads | What
C25803 | 3 | 2 | 100k 0603
C22807 | 1 | 2 | 150k 0603
C25804 | 13 | 2 | 10k 0603
C23140 | 2 | 2 | 33R 0603
C21190 | 4 | 2 | 1k 0603
C22775 | 11 | 2 | 100R 0603
C23162 | 12 | 2 | 4.7k 0603
C4190 | 10 | 2 | 2.2k 0603
C14663 | 16 | 2 | 100 nF 50 V 0603
C57112 | 4 | 2 | 10 nF 50 V 0603
C13585 | 1 | 2 | 10 uF 50 V 1206
C45783 | 5 | 2 | 22 uF 25 V 0805
C15850 | 1 | 2 | 10 uF 25 V 0805
C16133 | 2 | 2 | 100 uF 6.3 V tantalum B
C400894 | 1 | 3 | AOD4185 reverse-polarity FET
C19077573 | 1 | 2 | SMBJ18A TVS
C8678 | 1 | 2 | SS34
C8598 | 6 | 2 | B5819W
C2500 | 4 | 3 | BAV99
C7420376 | 5 | 6 | SRV05-4
C6186 | 2 | 4 | AMS1117-3.3
C130026 | 1 | 24 | TCA9548APWR
C20917 | 1 | 3 | AO3400A
C2892547 | 1 | 2 | NTC 10k 0603
