Aottens/PTZ-DriverBoard/mechanica/rig/export/fit_shaft.stl

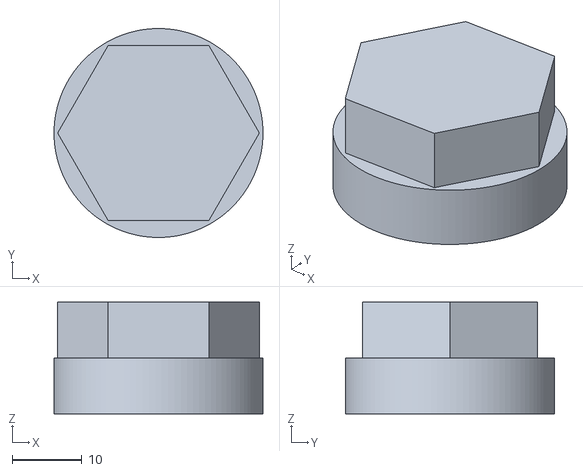
[picture p3: CAD file, 2026-11-10]
mechanica/rig/export/fit_shaft.stl
29.9 x 29.9 x 16.0
