Aottens/PTZ-DriverBoard/mechanica/rig/export/pulley_120T.stl

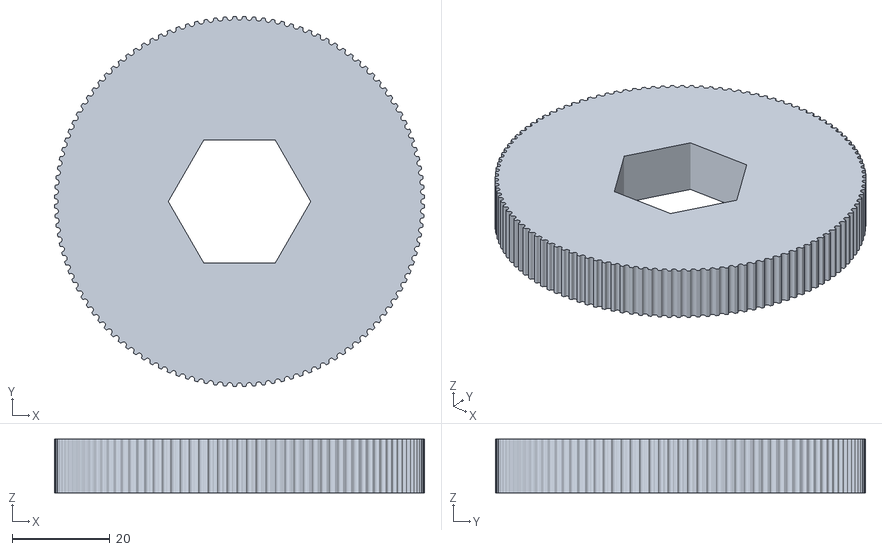
[picture p4: CAD file, 2026-11-10]
mechanica/rig/export/pulley_120T.stl
75.9 x 75.9 x 11.0
