Aottens/PTZ-DriverBoard/mechanica/rig/export/idler_spacer_top.stl

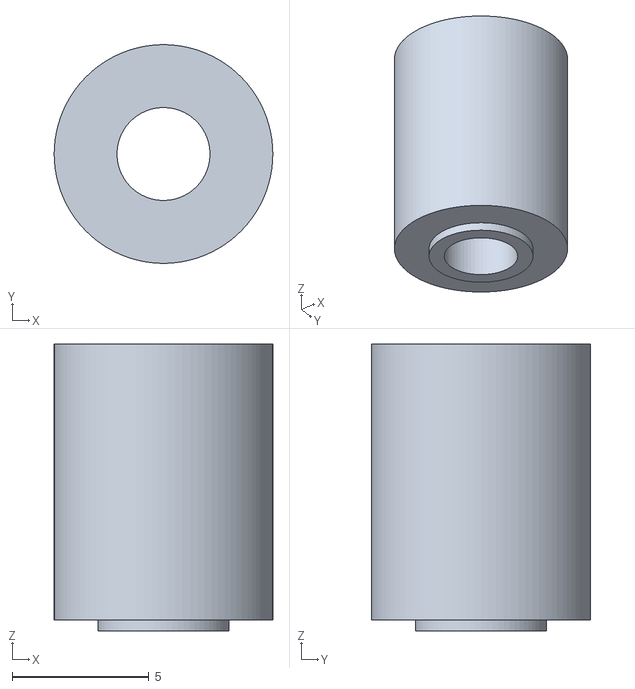
[picture p5: CAD file, 2026-11-10]
mechanica/rig/export/idler_spacer_top.stl
8.00 x 8.00 x 10.5
