Aottens/PTZ-DriverBoard/mechanica/rig/export/magnet_holder.stl

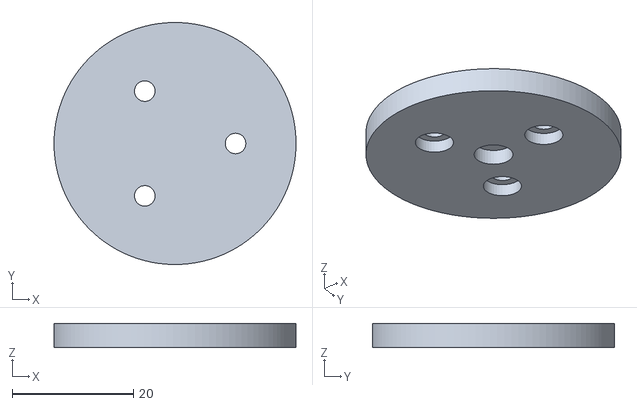
[picture p6: CAD file, 2026-11-10]
mechanica/rig/export/magnet_holder.stl
40.0 x 40.0 x 4.00
