Aottens/PTZ-DriverBoard/mechanica/rig/export/camera_plate.stl

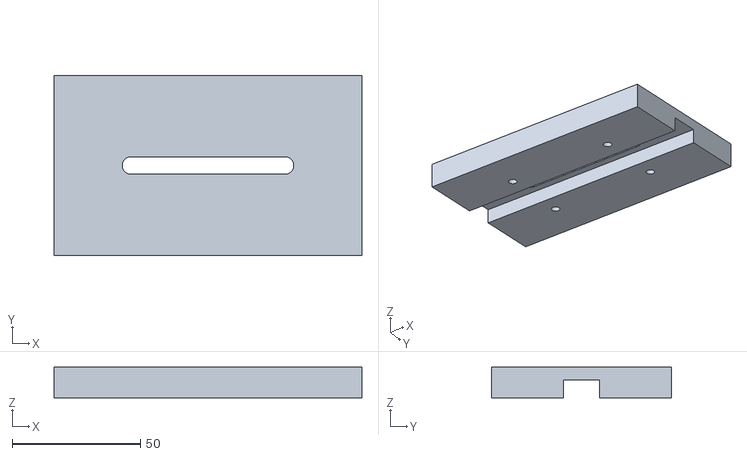
[picture p7: CAD file, 2026-11-10]
mechanica/rig/export/camera_plate.stl
120.0 x 70.0 x 12.0
