Aottens/PTZ-DriverBoard/mechanica/rig/export/top_plate.stl

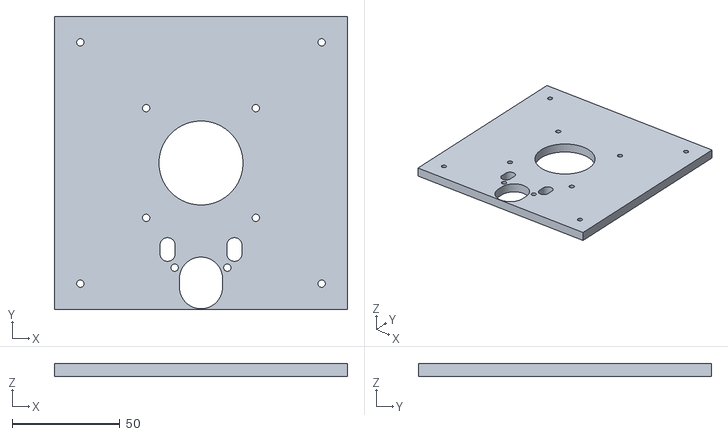
[picture p8: CAD file, 2026-11-10]
mechanica/rig/export/top_plate.stl
136.0 x 136.0 x 6.00
