Aottens/PTZ-DriverBoard/mechanica/rig/export/fit_seat.stl

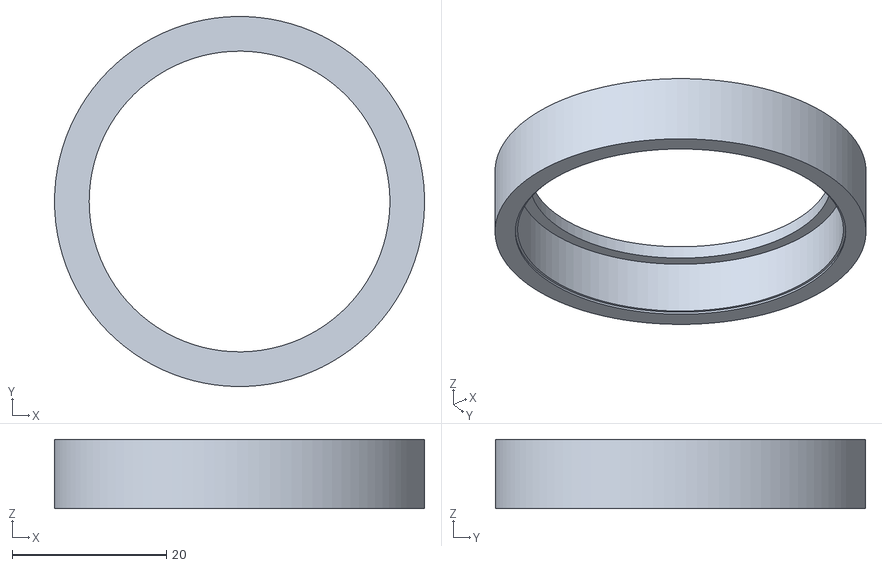
[picture p9: CAD file, 2026-11-10]
mechanica/rig/export/fit_seat.stl
48.0 x 48.0 x 9.00
