Aottens/PTZ-DriverBoard/mechanica/rig/export/pillar.stl

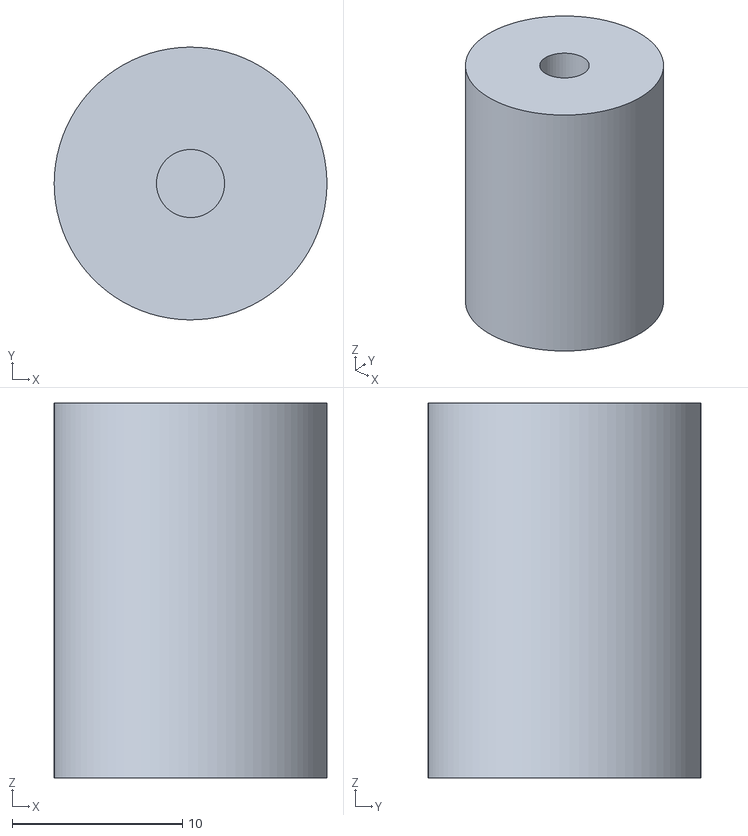
[picture p10: CAD file, 2026-11-10]
mechanica/rig/export/pillar.stl
16.0 x 16.0 x 22.0
