Aottens/PTZ-DriverBoard/mechanica/rig/export/bottom_plate.stl

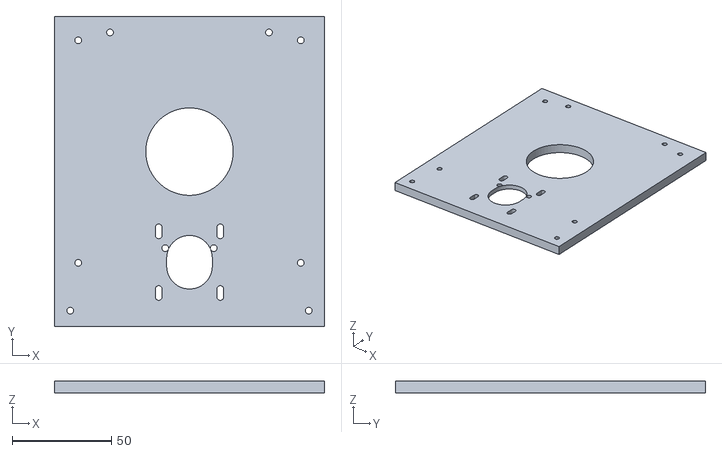
[picture p11: CAD file, 2026-11-10]
mechanica/rig/export/bottom_plate.stl
136.0 x 156.0 x 6.00
