Aottens/PTZ-DriverBoard/mechanica/rig/export/bearing_housing.stl

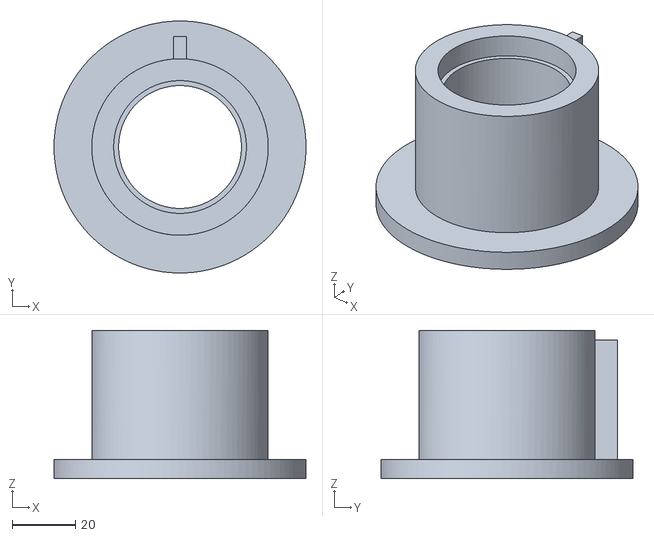
[picture p12: CAD file, 2026-11-10]
mechanica/rig/export/bearing_housing.stl
80.0 x 80.0 x 47.0
