Aottens/PTZ-DriverBoard/mechanica/rig/export/sensor_tray.stl

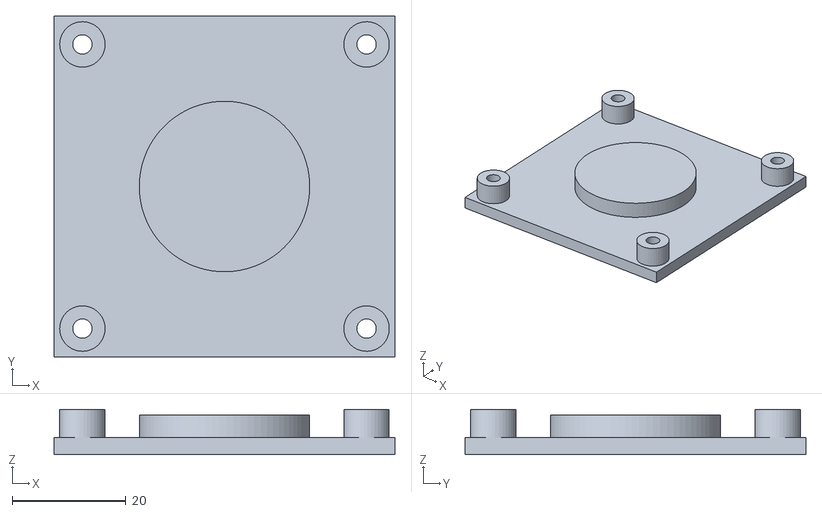
[picture p13: CAD file, 2026-11-10]
mechanica/rig/export/sensor_tray.stl
60.0 x 60.0 x 8.00
