Aottens/PTZ-DriverBoard/mechanica/rig/export/foot.stl

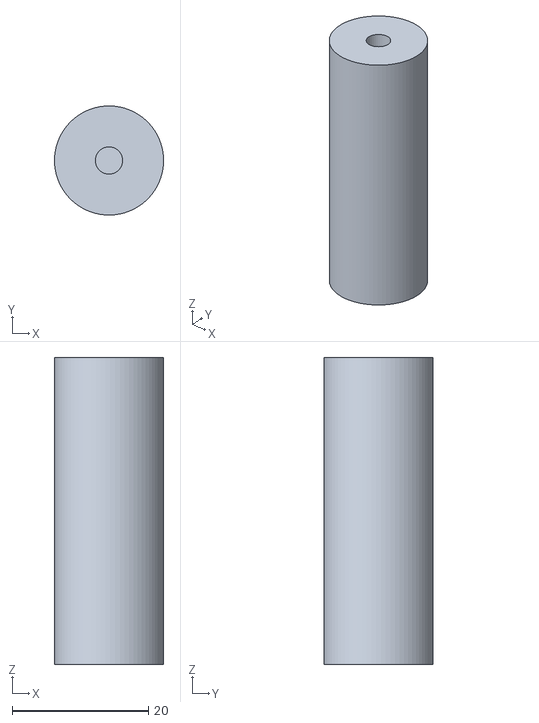
[picture p14: CAD file, 2026-11-10]
mechanica/rig/export/foot.stl
16.0 x 16.0 x 45.0
