Aottens/PTZ-DriverBoard/mechanica/rig/export/spacer.stl

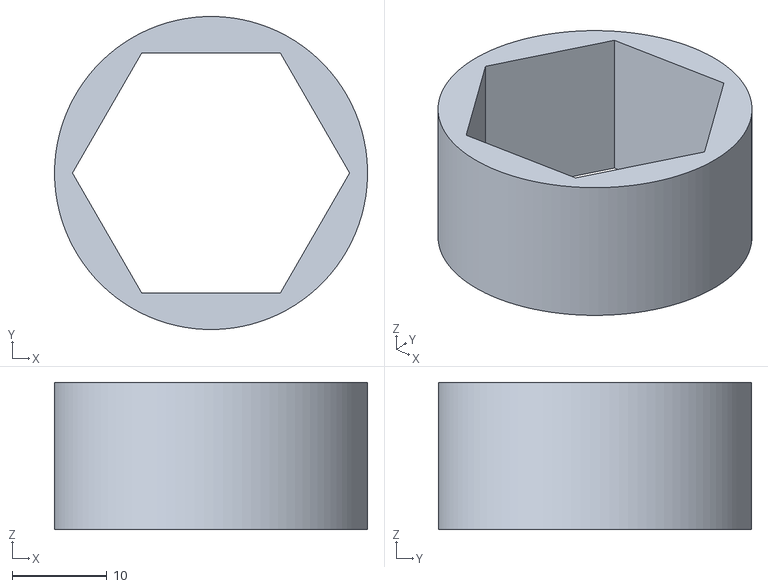
[picture p15: CAD file, 2026-11-10]
mechanica/rig/export/spacer.stl
33.0 x 33.0 x 15.5
