Aottens/PTZ-DriverBoard/mechanica/rig/export/pulley_100T.stl

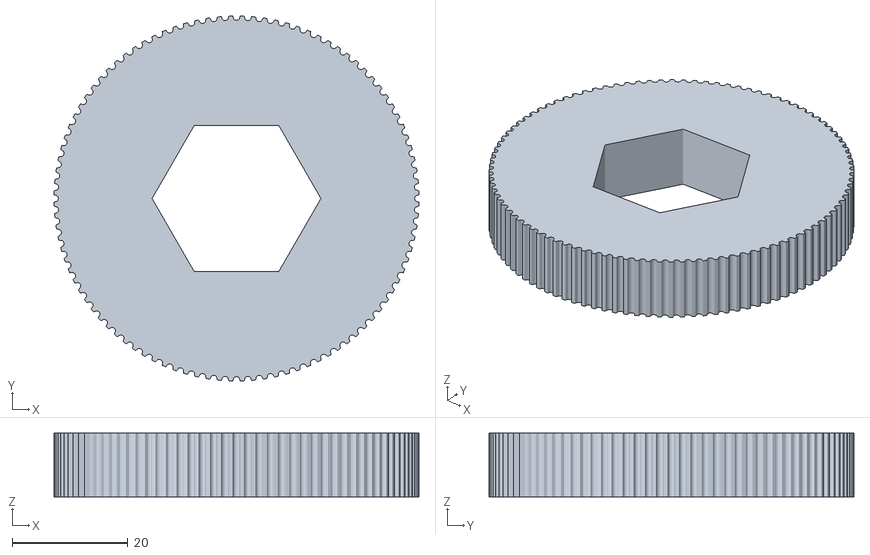
[picture p16: CAD file, 2026-11-10]
mechanica/rig/export/pulley_100T.stl
63.1 x 63.1 x 11.0
