Aottens/PTZ-DriverBoard/mechanica/rig/export/output_shaft.stl

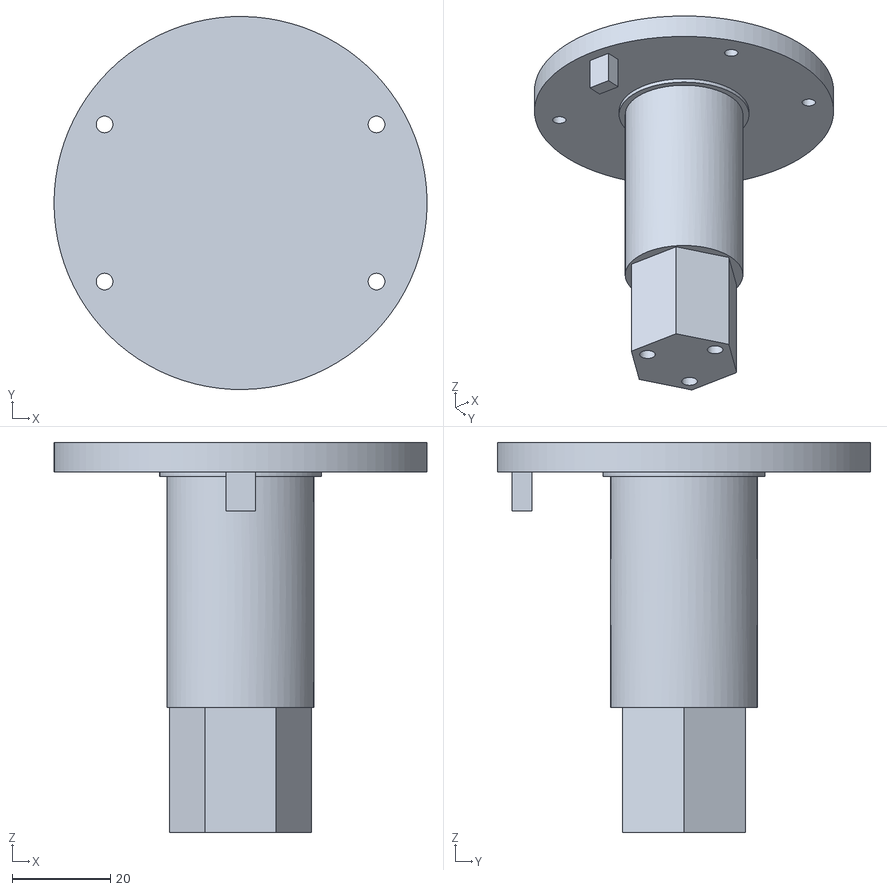
[picture p17: CAD file, 2026-11-10]
mechanica/rig/export/output_shaft.stl
76.0 x 76.0 x 79.5
