Aottens/PTZ-DriverBoard/mechanica/rig/export/idler_spacer_low.stl

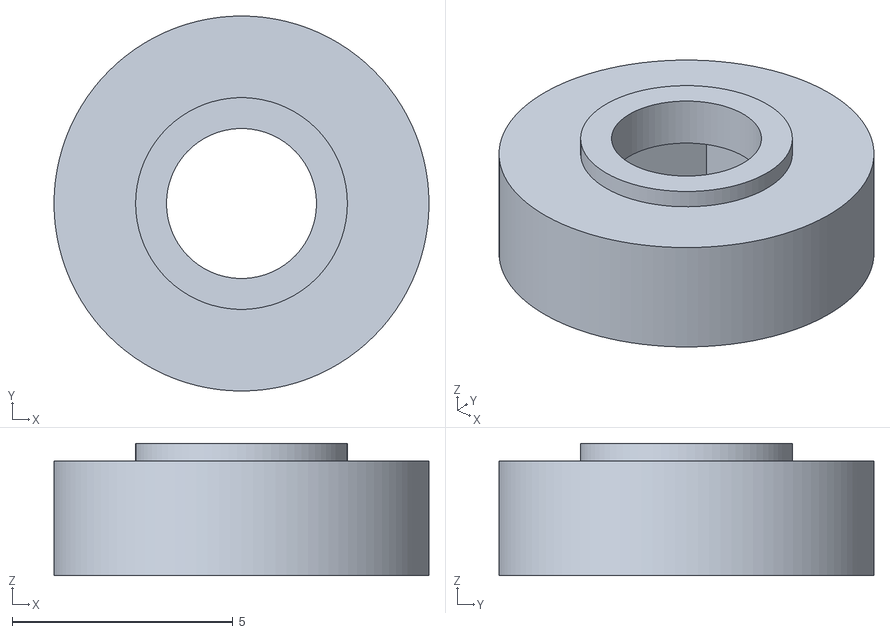
[picture p18: CAD file, 2026-11-10]
mechanica/rig/export/idler_spacer_low.stl
8.50 x 8.50 x 3.00
