Aottens/PTZ-DriverBoard/(list of files, cad)

Other CAD files:
mechanica/rig/export/rig.f3d
