Aottens/PTZ-DriverBoard/docs/history/2026-07-maattekening.png

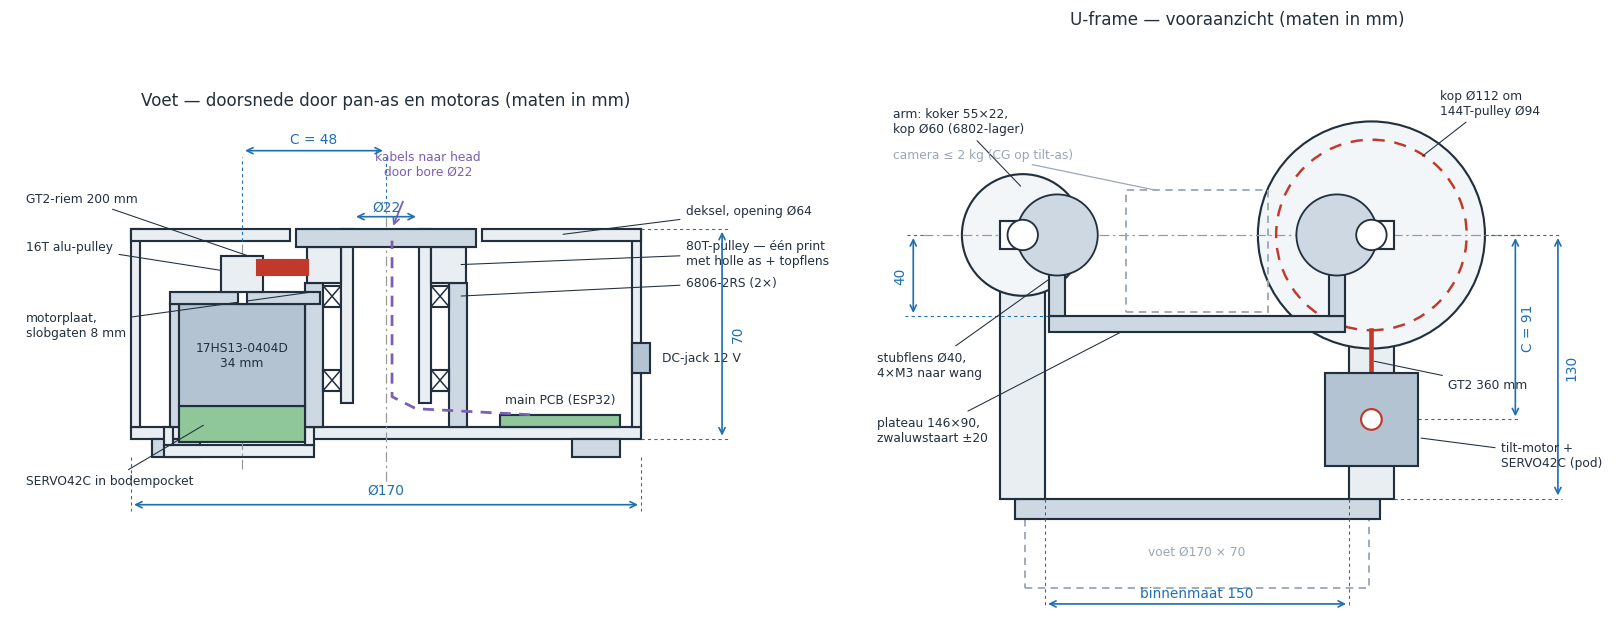
docs/history/2026-07-maattekening.png
