Aottens/PTZ-DriverBoard/(list of files, drawings)

Other design files:
hardware/fab/easyeda_cache.json
hardware/fab/easyeda_pins.json
