Aottens/PTZ-DriverBoard/hardware/ptz-driver.kicad_pcb

## KiCad design hardware/ptz-driver.kicad_pcb (2026-11-11)

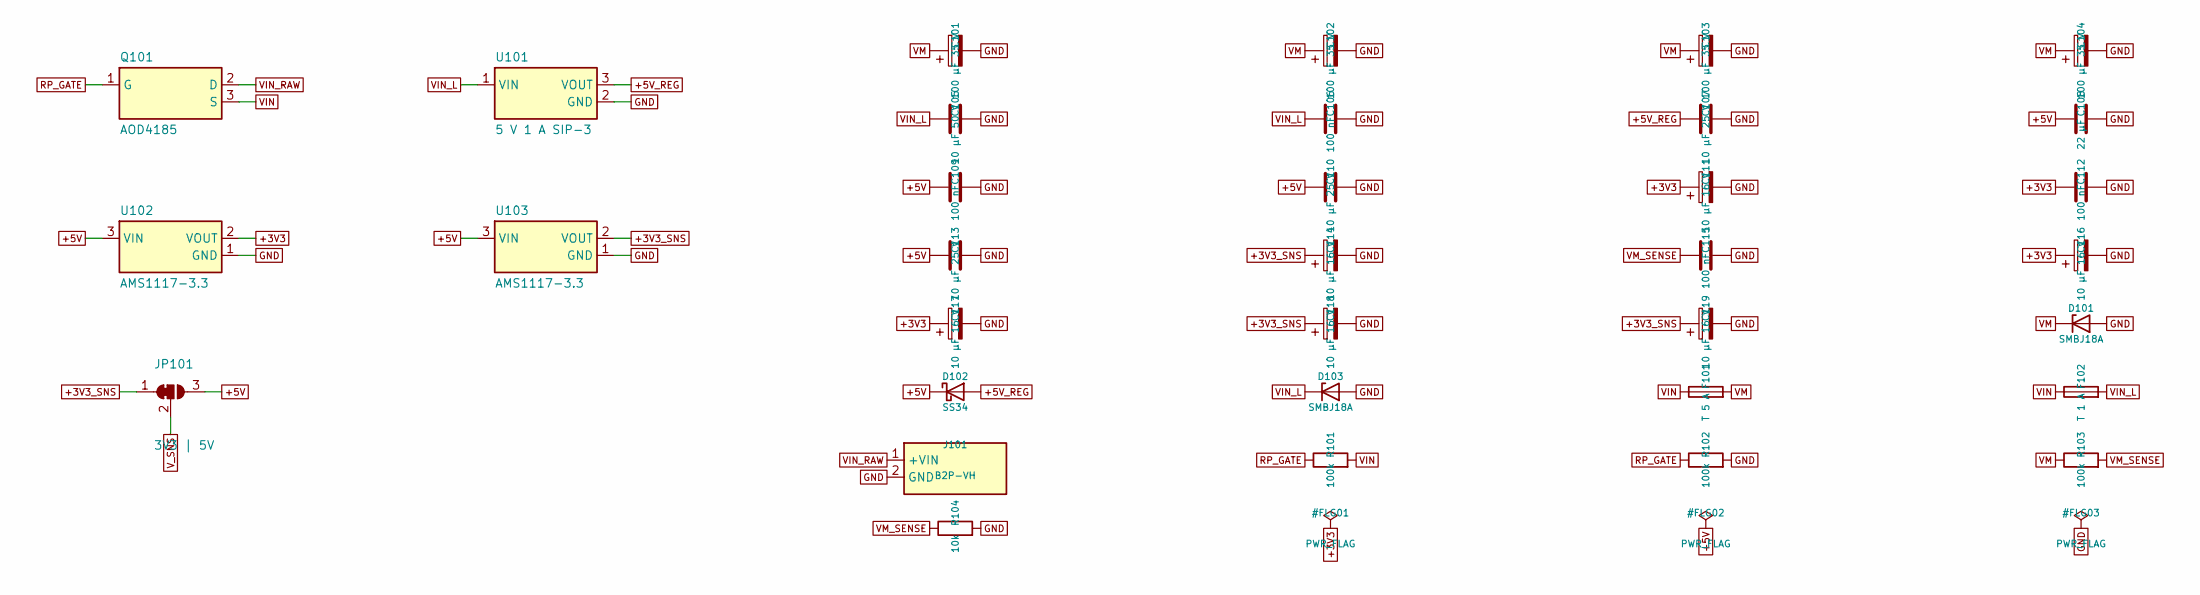
[picture p20: schematic power.kicad_sch, Power: input protection, 5 V module, 3.3 V rails]

Parts:
C101, C102, C103, C104: 100 µF 35 V; CP_Radial_D6.3mm_P2.50mm
C105: 10 µF 50 V; C_1206_3216Metric; LCSC C13585
C106, C109, C112, C115: 100 nF; C_0603_1608Metric; LCSC C14663
C107, C110, C113: 10 µF 25 V; C_0805_2012Metric; LCSC C15850
C108: 22 µF; C_0805_2012Metric; LCSC C45783
C111, C114, C116, C117, C118, C119: 10 µF 16 V; CP_EIA-3216-18_Kemet-A; MPN TAJA106K016RNJ; LCSC C7171
D101, D103: SMBJ18A; D_SMB; MPN SMBJ18A; LCSC C19077573
D102: SS34; D_SMA; MPN SS34; LCSC C8678
F101: T 5 A; Fuseholder_TR5_Littelfuse_No560_No460
F102: T 1 A; Fuseholder_TR5_Littelfuse_No560_No460
J101: B2P-VH; JST_VH_B2P-VH_1x02_P3.96mm_Vertical
JP101: 3V3 | 5V; SolderJumper-3_P1.3mm_Bridged12_RoundedPad1.0x1.5mm
Q101: AOD4185; TO-252_JLC; MPN AOD4185; LCSC C400894
R101, R102, R103: 100k; R_0603_1608Metric; LCSC C25803
R104: 10k; R_0603_1608Metric; LCSC C25804
U101: 5 V 1 A SIP-3; SIP3_DCDC_7805
U102, U103: AMS1117-3.3; SOT-223-3_TabPin2; MPN AMS1117-3.3; LCSC C6186

Connections:
+3V3: C111.1, C112.1, C116.1, C117.1, U102.2 (VOUT); also elsewhere on the board
+3V3_SNS: C114.1, C118.1, C119.1, JP101.1 (A), U103.2 (VOUT)
+5V: C108.1, C109.1, C110.1, C113.1, D102.1 (K), JP101.3 (B), U102.3 (VIN), U103.3 (VIN); also elsewhere on the board
+5V_REG: C107.1, D102.2 (A), U101.3 (VOUT)
GND: C101.2, C102.2, C103.2, C104.2, C105.2, C106.2, C107.2, C108.2, C109.2, C110.2, C111.2, C112.2, C113.2, C114.2, C115.2, C116.2, C117.2, C118.2, C119.2, D101.2 (A), D103.2 (A), J101.2 (GND), R102.2, R104.2, U101.2 (GND), U102.1 (GND), U103.1 (GND); also elsewhere on the board
RP_GATE: Q101.1 (G), R101.1, R102.1
VIN: F101.1, F102.1, Q101.3 (S), R101.2; also elsewhere on the board
VIN_L: C105.1, C106.1, D103.1 (K), F102.2, U101.1 (VIN)
VIN_RAW: J101.1 (+VIN), Q101.2 (D)
VM: C101.1, C102.1, C103.1, C104.1, D101.1 (K), F101.2, R103.1; also elsewhere on the board
VM_SENSE: C115.1, R103.2, R104.1; also elsewhere on the board
V_SNS: JP101.2 (C); also elsewhere on the board

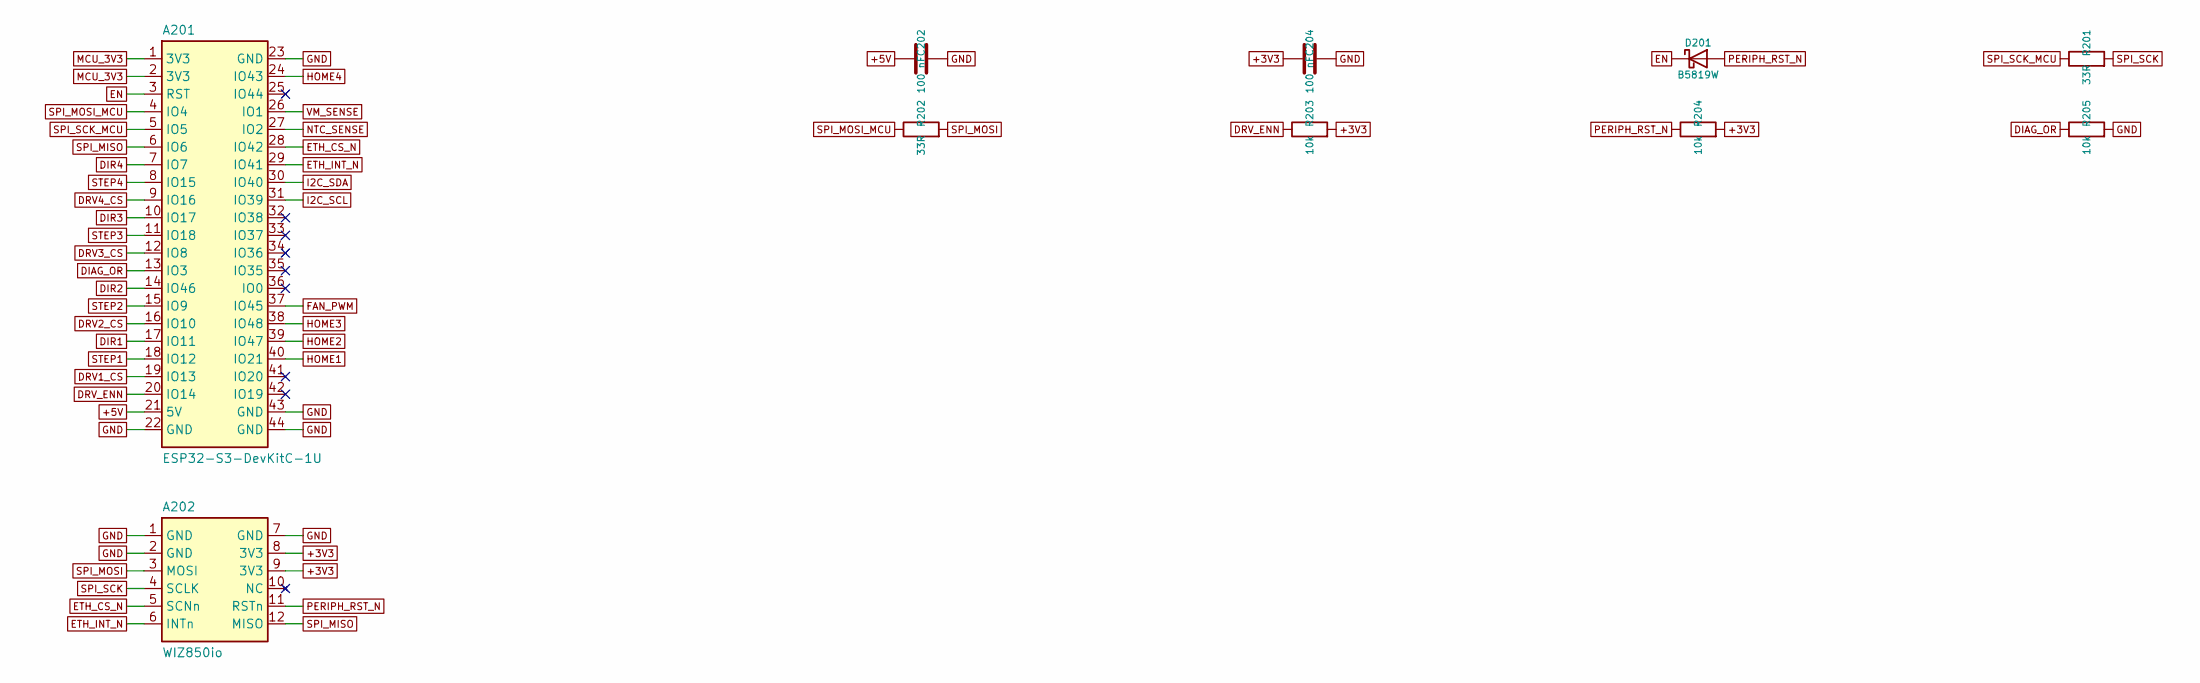
[picture p21: schematic mcu.kicad_sch, MCU module, Ethernet module, SPI bus, reset]

Parts:
A201: ESP32-S3-DevKitC-1U; ESP32-S3-DevKitC-1
A202: WIZ850io
C202, C204: 100 nF; C_0603_1608Metric; LCSC C14663
D201: B5819W; D_SOD-123; MPN B5819W; LCSC C8598
R201, R202: 33R; R_0603_1608Metric; LCSC C23140
R203, R204, R205: 10k; R_0603_1608Metric; LCSC C25804

Connections:
+3V3: A202.8 (3V3), A202.9 (3V3), C204.1, R203.2, R204.2; also elsewhere on the board
+5V: A201.21 (5V), C202.1; also elsewhere on the board
DIAG_OR: A201.13 (IO3), R205.1; also elsewhere on the board
DIR1: A201.17 (IO11); also elsewhere on the board
DIR2: A201.14 (IO46); also elsewhere on the board
DIR3: A201.10 (IO17); also elsewhere on the board
DIR4: A201.7 (IO7); also elsewhere on the board
DRV1_CS: A201.19 (IO13); also elsewhere on the board
DRV2_CS: A201.16 (IO10); also elsewhere on the board
DRV3_CS: A201.12 (IO8); also elsewhere on the board
DRV4_CS: A201.9 (IO16); also elsewhere on the board
DRV_ENN: A201.20 (IO14), R203.1; also elsewhere on the board
EN: A201.3 (RST), D201.1 (K)
ETH_CS_N: A201.28 (IO42), A202.5 (SCNn)
ETH_INT_N: A201.29 (IO41), A202.6 (INTn)
FAN_PWM: A201.37 (IO45); also elsewhere on the board
GND: A201.22 (GND), A201.23 (GND), A201.43 (GND), A201.44 (GND), A202.1 (GND), A202.2 (GND), A202.7 (GND), C202.2, C204.2, R205.2; also elsewhere on the board
HOME1: A201.40 (IO21); also elsewhere on the board
HOME2: A201.39 (IO47); also elsewhere on the board
HOME3: A201.38 (IO48); also elsewhere on the board
HOME4: A201.24 (IO43); also elsewhere on the board
I2C_SCL: A201.31 (IO39); also elsewhere on the board
I2C_SDA: A201.30 (IO40); also elsewhere on the board
MCU_3V3: A201.1 (3V3), A201.2 (3V3); also elsewhere on the board
NTC_SENSE: A201.27 (IO2); also elsewhere on the board
PERIPH_RST_N: A202.11 (RSTn), D201.2 (A), R204.1; also elsewhere on the board
SPI_MISO: A201.6 (IO6), A202.12 (MISO); also elsewhere on the board
SPI_MOSI: A202.3 (MOSI), R202.2; also elsewhere on the board
SPI_MOSI_MCU: A201.4 (IO4), R202.1
SPI_SCK: A202.4 (SCLK), R201.2; also elsewhere on the board
SPI_SCK_MCU: A201.5 (IO5), R201.1
STEP1: A201.18 (IO12); also elsewhere on the board
STEP2: A201.15 (IO9); also elsewhere on the board
STEP3: A201.11 (IO18); also elsewhere on the board
STEP4: A201.8 (IO15); also elsewhere on the board
VM_SENSE: A201.26 (IO1); also elsewhere on the board

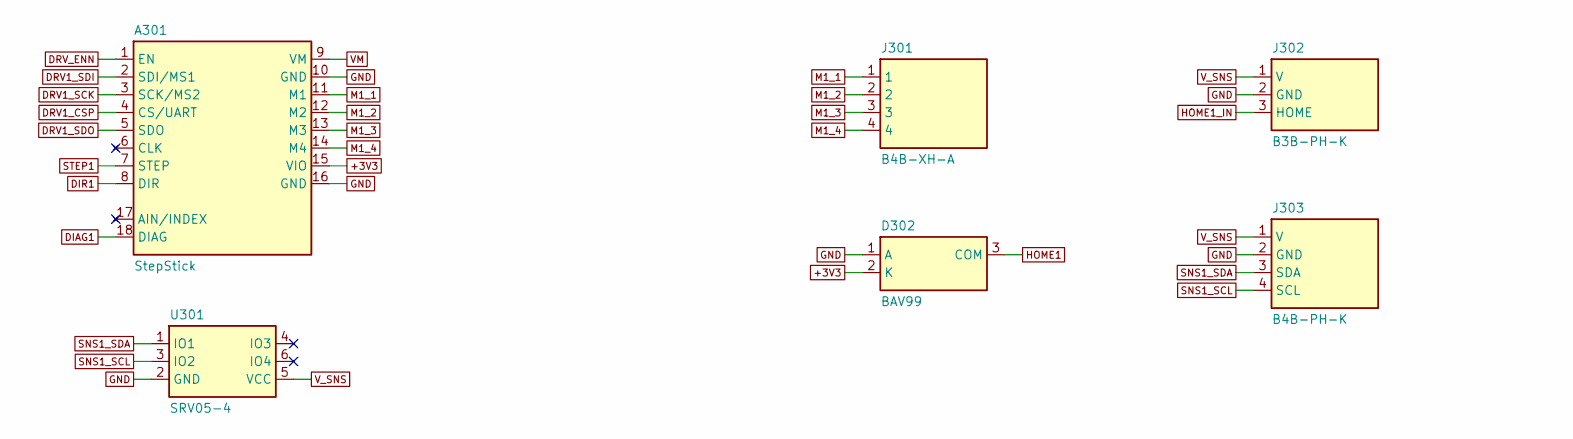
[picture p22: schematic axis1.kicad_sch, Axis 1: driver socket, motor, home input, sensor port, part in row 1, column 1]

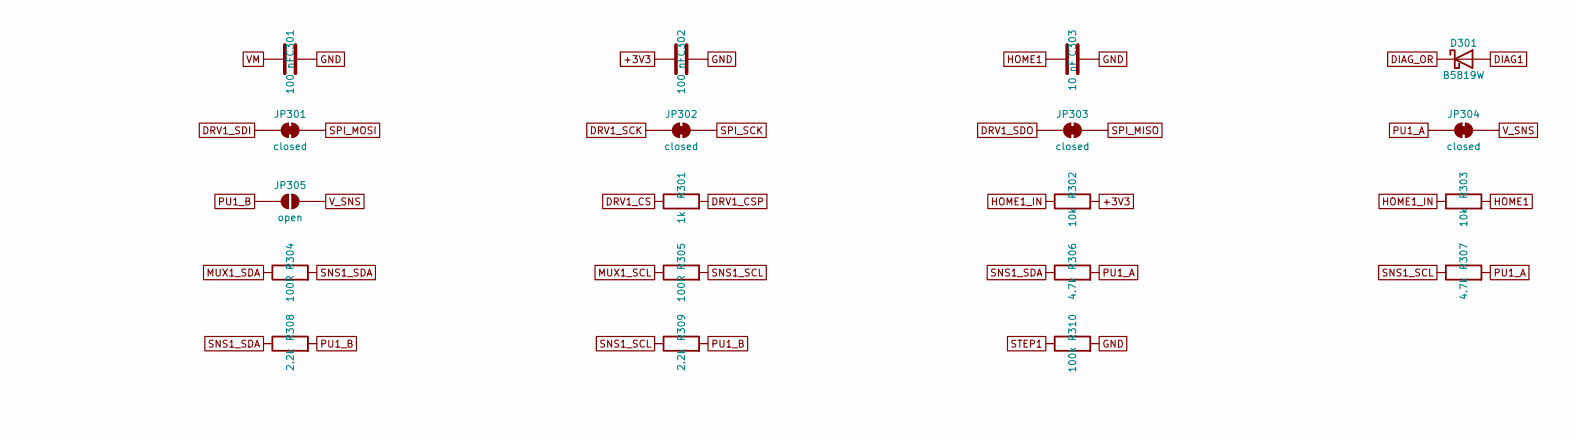
[picture p23: schematic axis1.kicad_sch, Axis 1: driver socket, motor, home input, sensor port, part in row 1, column 2]

Parts:
A301: StepStick; StepStick_Socket
C301, C302: 100 nF; C_0603_1608Metric; LCSC C14663
C303: 10 nF; C_0603_1608Metric; LCSC C57112
D301: B5819W; D_SOD-123; MPN B5819W; LCSC C8598
D302: BAV99; SOT-23; MPN BAV99,215; LCSC C2500
J301: B4B-XH-A; JST_XH_B4B-XH-A_1x04_P2.50mm_Vertical
J302: B3B-PH-K; JST_PH_B3B-PH-K_1x03_P2.00mm_Vertical
J303: B4B-PH-K; JST_PH_B4B-PH-K_1x04_P2.00mm_Vertical
JP301, JP302, JP303, JP304: closed; SolderJumper-2_P1.3mm_Bridged_RoundedPad1.0x1.5mm
JP305: open; SolderJumper-2_P1.3mm_Open_RoundedPad1.0x1.5mm
R301: 1k; R_0603_1608Metric; LCSC C21190
R302, R303: 10k; R_0603_1608Metric; LCSC C25804
R304, R305: 100R; R_0603_1608Metric; LCSC C22775
R306, R307: 4.7k; R_0603_1608Metric; LCSC C23162
R308, R309: 2.2k; R_0603_1608Metric; LCSC C4190
R310: 100k; R_0603_1608Metric; LCSC C25803
U301: SRV05-4; SOT-23-6; MPN SRV05-4; LCSC C7420376

Connections:
+3V3: A301.15 (VIO), C302.1, D302.2 (K), R302.2; also elsewhere on the board
DIAG1: A301.18 (DIAG), D301.2 (A)
DIAG_OR: D301.1 (K); also elsewhere on the board
DIR1: A301.8 (DIR); also elsewhere on the board
DRV1_CS: R301.1; also elsewhere on the board
DRV1_CSP: A301.4 (CS/UART), R301.2
DRV1_SCK: A301.3 (SCK/MS2), JP302.1 (A)
DRV1_SDI: A301.2 (SDI/MS1), JP301.1 (A)
DRV1_SDO: A301.5 (SDO), JP303.1 (A)
DRV_ENN: A301.1 (EN); also elsewhere on the board
GND: A301.10 (GND), A301.16 (GND), C301.2, C302.2, C303.2, D302.1 (A), J302.2 (GND), J303.2 (GND), R310.2, U301.2 (GND); also elsewhere on the board
HOME1: C303.1, D302.3 (COM), R303.2; also elsewhere on the board
HOME1_IN: J302.3 (HOME), R302.1, R303.1
M1_1: A301.11 (M1), J301.1
M1_2: A301.12 (M2), J301.2
M1_3: A301.13 (M3), J301.3
M1_4: A301.14 (M4), J301.4
MUX1_SCL: R305.1; also elsewhere on the board
MUX1_SDA: R304.1; also elsewhere on the board
PU1_A: JP304.1 (A), R306.2, R307.2
PU1_B: JP305.1 (A), R308.2, R309.2
SNS1_SCL: J303.4 (SCL), R305.2, R307.1, R309.1, U301.3 (IO2)
SNS1_SDA: J303.3 (SDA), R304.2, R306.1, R308.1, U301.1 (IO1)
SPI_MISO: JP303.2 (B); also elsewhere on the board
SPI_MOSI: JP301.2 (B); also elsewhere on the board
SPI_SCK: JP302.2 (B); also elsewhere on the board
STEP1: A301.7 (STEP), R310.1; also elsewhere on the board
VM: A301.9 (VM), C301.1; also elsewhere on the board
V_SNS: J302.1 (V), J303.1 (V), JP304.2 (B), JP305.2 (B), U301.5 (VCC); also elsewhere on the board

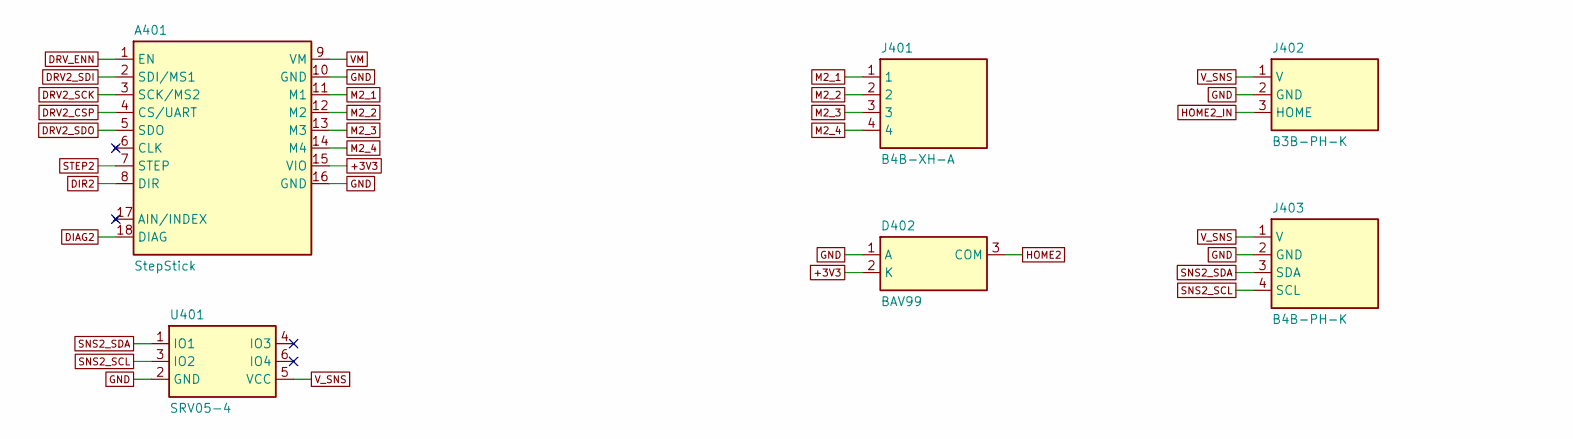
[picture p24: schematic axis2.kicad_sch, Axis 2: driver socket, motor, home input, sensor port, part in row 1, column 1]

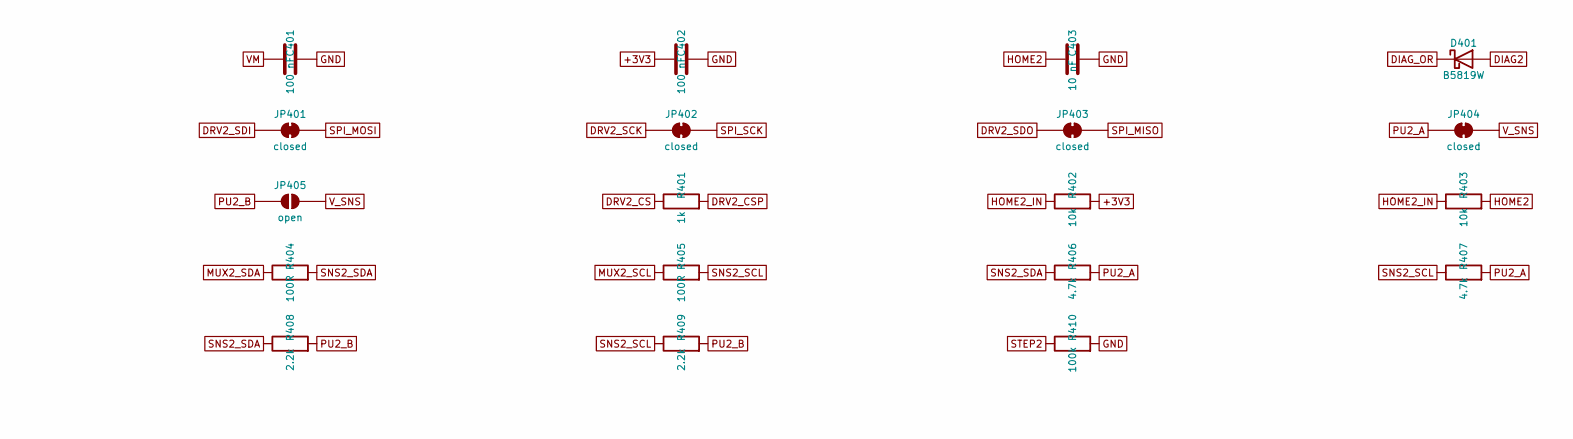
[picture p25: schematic axis2.kicad_sch, Axis 2: driver socket, motor, home input, sensor port, part in row 1, column 2]

Parts:
A401: StepStick; StepStick_Socket
C401, C402: 100 nF; C_0603_1608Metric; LCSC C14663
C403: 10 nF; C_0603_1608Metric; LCSC C57112
D401: B5819W; D_SOD-123; MPN B5819W; LCSC C8598
D402: BAV99; SOT-23; MPN BAV99,215; LCSC C2500
J401: B4B-XH-A; JST_XH_B4B-XH-A_1x04_P2.50mm_Vertical
J402: B3B-PH-K; JST_PH_B3B-PH-K_1x03_P2.00mm_Vertical
J403: B4B-PH-K; JST_PH_B4B-PH-K_1x04_P2.00mm_Vertical
JP401, JP402, JP403, JP404: closed; SolderJumper-2_P1.3mm_Bridged_RoundedPad1.0x1.5mm
JP405: open; SolderJumper-2_P1.3mm_Open_RoundedPad1.0x1.5mm
R401: 1k; R_0603_1608Metric; LCSC C21190
R402, R403: 10k; R_0603_1608Metric; LCSC C25804
R404, R405: 100R; R_0603_1608Metric; LCSC C22775
R406, R407: 4.7k; R_0603_1608Metric; LCSC C23162
R408, R409: 2.2k; R_0603_1608Metric; LCSC C4190
R410: 100k; R_0603_1608Metric; LCSC C25803
U401: SRV05-4; SOT-23-6; MPN SRV05-4; LCSC C7420376

Connections:
+3V3: A401.15 (VIO), C402.1, D402.2 (K), R402.2; also elsewhere on the board
DIAG2: A401.18 (DIAG), D401.2 (A)
DIAG_OR: D401.1 (K); also elsewhere on the board
DIR2: A401.8 (DIR); also elsewhere on the board
DRV2_CS: R401.1; also elsewhere on the board
DRV2_CSP: A401.4 (CS/UART), R401.2
DRV2_SCK: A401.3 (SCK/MS2), JP402.1 (A)
DRV2_SDI: A401.2 (SDI/MS1), JP401.1 (A)
DRV2_SDO: A401.5 (SDO), JP403.1 (A)
DRV_ENN: A401.1 (EN); also elsewhere on the board
GND: A401.10 (GND), A401.16 (GND), C401.2, C402.2, C403.2, D402.1 (A), J402.2 (GND), J403.2 (GND), R410.2, U401.2 (GND); also elsewhere on the board
HOME2: C403.1, D402.3 (COM), R403.2; also elsewhere on the board
HOME2_IN: J402.3 (HOME), R402.1, R403.1
M2_1: A401.11 (M1), J401.1
M2_2: A401.12 (M2), J401.2
M2_3: A401.13 (M3), J401.3
M2_4: A401.14 (M4), J401.4
MUX2_SCL: R405.1; also elsewhere on the board
MUX2_SDA: R404.1; also elsewhere on the board
PU2_A: JP404.1 (A), R406.2, R407.2
PU2_B: JP405.1 (A), R408.2, R409.2
SNS2_SCL: J403.4 (SCL), R405.2, R407.1, R409.1, U401.3 (IO2)
SNS2_SDA: J403.3 (SDA), R404.2, R406.1, R408.1, U401.1 (IO1)
SPI_MISO: JP403.2 (B); also elsewhere on the board
SPI_MOSI: JP401.2 (B); also elsewhere on the board
SPI_SCK: JP402.2 (B); also elsewhere on the board
STEP2: A401.7 (STEP), R410.1; also elsewhere on the board
VM: A401.9 (VM), C401.1; also elsewhere on the board
V_SNS: J402.1 (V), J403.1 (V), JP404.2 (B), JP405.2 (B), U401.5 (VCC); also elsewhere on the board

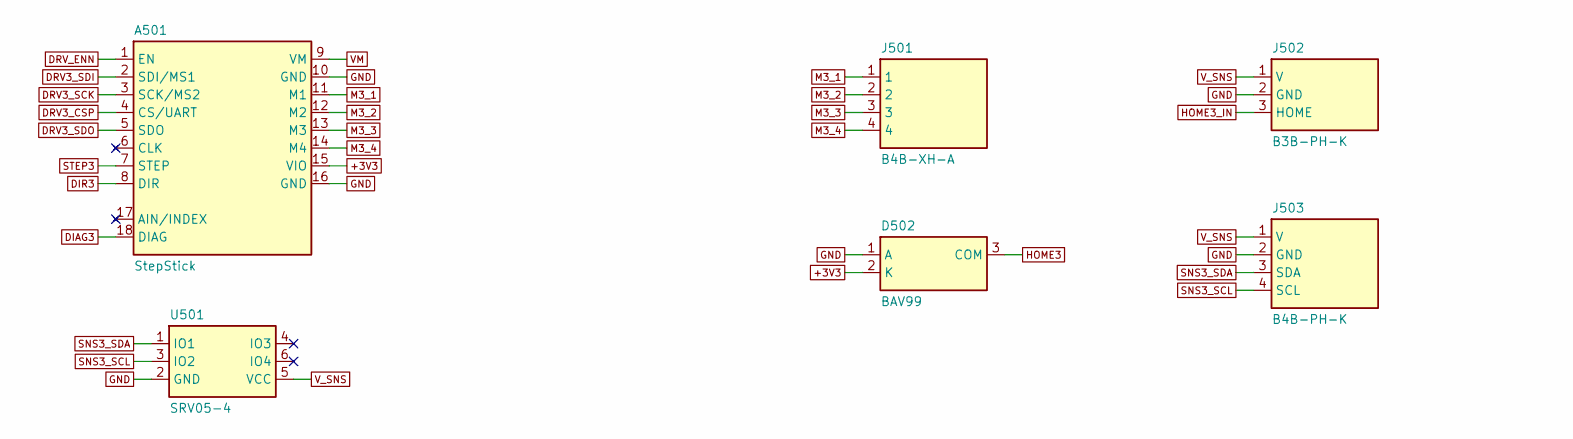
[picture p26: schematic axis3.kicad_sch, Axis 3: driver socket, motor, home input, sensor port, part in row 1, column 1]

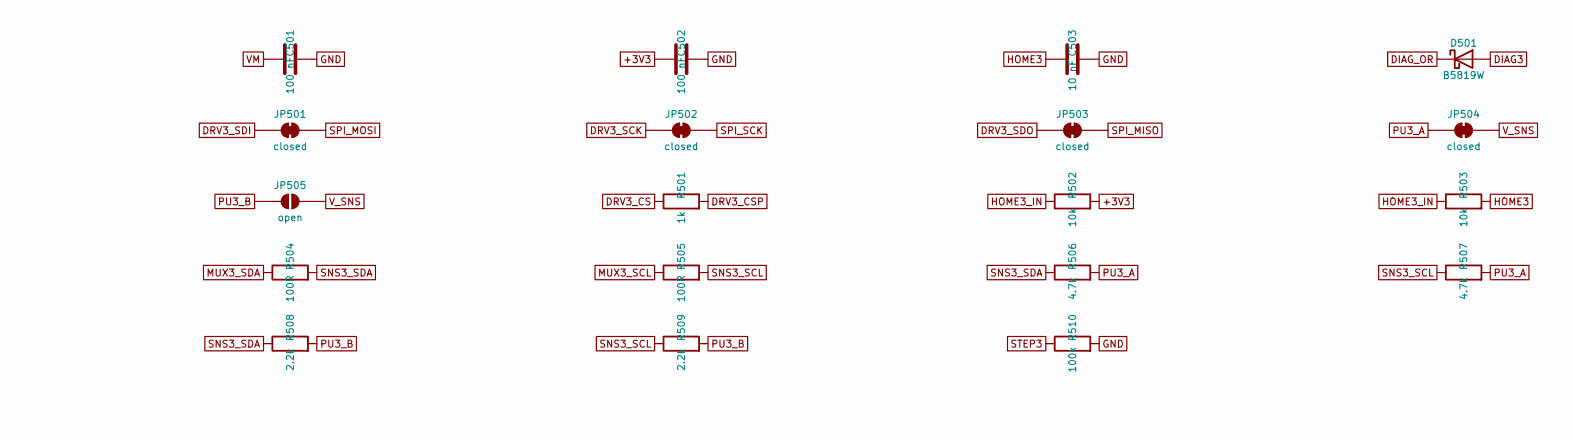
[picture p27: schematic axis3.kicad_sch, Axis 3: driver socket, motor, home input, sensor port, part in row 1, column 2]

Parts:
A501: StepStick; StepStick_Socket
C501, C502: 100 nF; C_0603_1608Metric; LCSC C14663
C503: 10 nF; C_0603_1608Metric; LCSC C57112
D501: B5819W; D_SOD-123; MPN B5819W; LCSC C8598
D502: BAV99; SOT-23; MPN BAV99,215; LCSC C2500
J501: B4B-XH-A; JST_XH_B4B-XH-A_1x04_P2.50mm_Vertical
J502: B3B-PH-K; JST_PH_B3B-PH-K_1x03_P2.00mm_Vertical
J503: B4B-PH-K; JST_PH_B4B-PH-K_1x04_P2.00mm_Vertical
JP501, JP502, JP503, JP504: closed; SolderJumper-2_P1.3mm_Bridged_RoundedPad1.0x1.5mm
JP505: open; SolderJumper-2_P1.3mm_Open_RoundedPad1.0x1.5mm
R501: 1k; R_0603_1608Metric; LCSC C21190
R502, R503: 10k; R_0603_1608Metric; LCSC C25804
R504, R505: 100R; R_0603_1608Metric; LCSC C22775
R506, R507: 4.7k; R_0603_1608Metric; LCSC C23162
R508, R509: 2.2k; R_0603_1608Metric; LCSC C4190
R510: 100k; R_0603_1608Metric; LCSC C25803
U501: SRV05-4; SOT-23-6; MPN SRV05-4; LCSC C7420376

Connections:
+3V3: A501.15 (VIO), C502.1, D502.2 (K), R502.2; also elsewhere on the board
DIAG3: A501.18 (DIAG), D501.2 (A)
DIAG_OR: D501.1 (K); also elsewhere on the board
DIR3: A501.8 (DIR); also elsewhere on the board
DRV3_CS: R501.1; also elsewhere on the board
DRV3_CSP: A501.4 (CS/UART), R501.2
DRV3_SCK: A501.3 (SCK/MS2), JP502.1 (A)
DRV3_SDI: A501.2 (SDI/MS1), JP501.1 (A)
DRV3_SDO: A501.5 (SDO), JP503.1 (A)
DRV_ENN: A501.1 (EN); also elsewhere on the board
GND: A501.10 (GND), A501.16 (GND), C501.2, C502.2, C503.2, D502.1 (A), J502.2 (GND), J503.2 (GND), R510.2, U501.2 (GND); also elsewhere on the board
HOME3: C503.1, D502.3 (COM), R503.2; also elsewhere on the board
HOME3_IN: J502.3 (HOME), R502.1, R503.1
M3_1: A501.11 (M1), J501.1
M3_2: A501.12 (M2), J501.2
M3_3: A501.13 (M3), J501.3
M3_4: A501.14 (M4), J501.4
MUX3_SCL: R505.1; also elsewhere on the board
MUX3_SDA: R504.1; also elsewhere on the board
PU3_A: JP504.1 (A), R506.2, R507.2
PU3_B: JP505.1 (A), R508.2, R509.2
SNS3_SCL: J503.4 (SCL), R505.2, R507.1, R509.1, U501.3 (IO2)
SNS3_SDA: J503.3 (SDA), R504.2, R506.1, R508.1, U501.1 (IO1)
SPI_MISO: JP503.2 (B); also elsewhere on the board
SPI_MOSI: JP501.2 (B); also elsewhere on the board
SPI_SCK: JP502.2 (B); also elsewhere on the board
STEP3: A501.7 (STEP), R510.1; also elsewhere on the board
VM: A501.9 (VM), C501.1; also elsewhere on the board
V_SNS: J502.1 (V), J503.1 (V), JP504.2 (B), JP505.2 (B), U501.5 (VCC); also elsewhere on the board

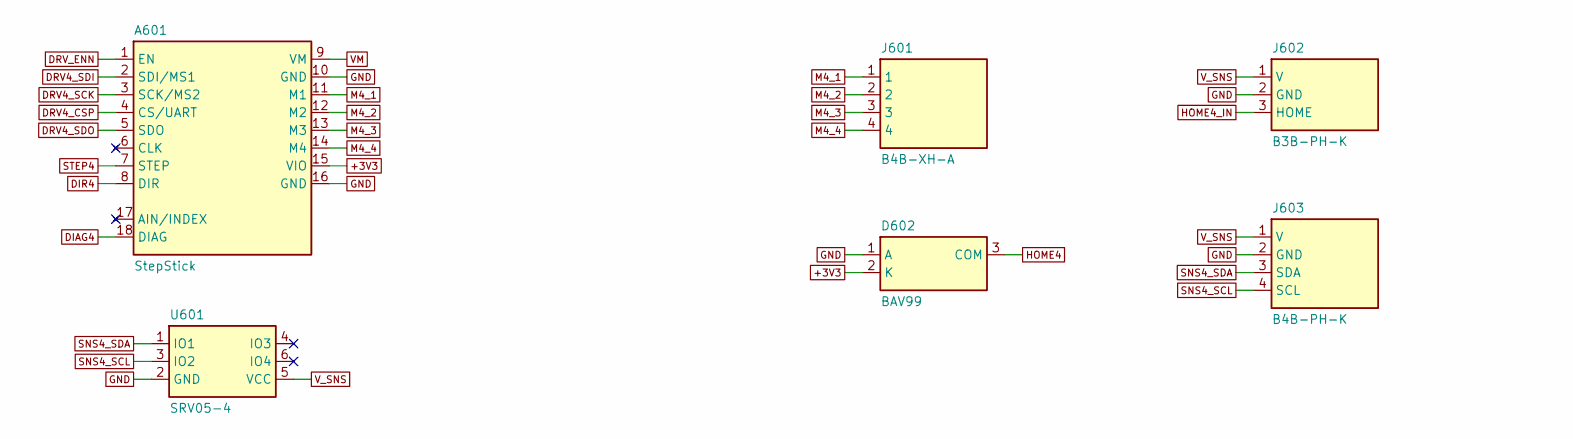
[picture p28: schematic axis4.kicad_sch, Axis 4: driver socket, motor, home input, sensor port, part in row 1, column 1]

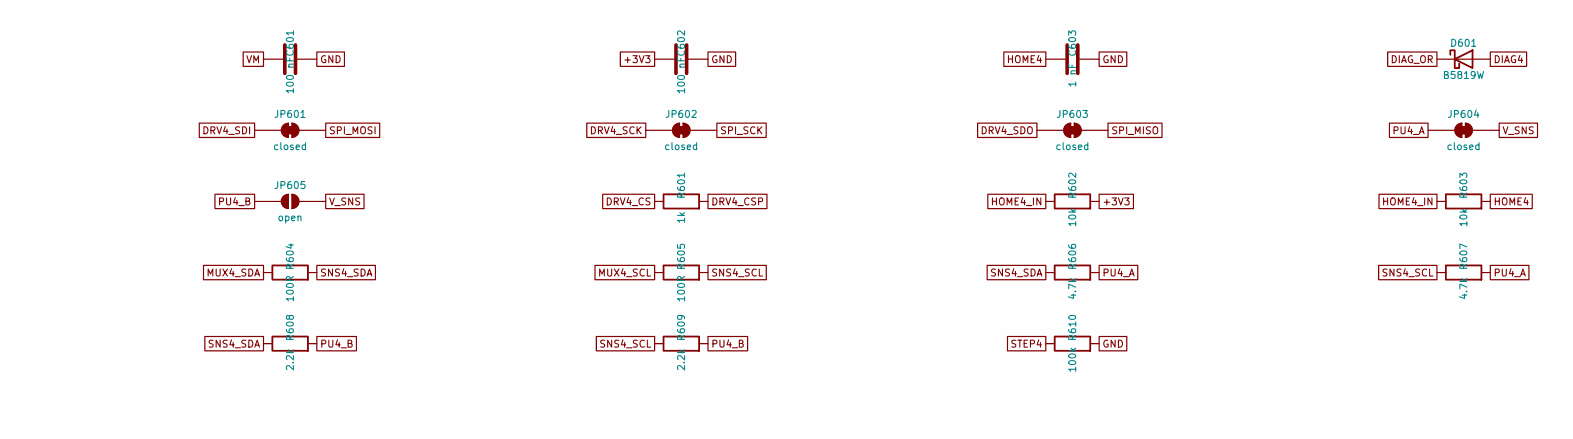
[picture p29: schematic axis4.kicad_sch, Axis 4: driver socket, motor, home input, sensor port, part in row 1, column 2]

Parts:
A601: StepStick; StepStick_Socket
C601, C602: 100 nF; C_0603_1608Metric; LCSC C14663
C603: 1 nF; C_0603_1608Metric; LCSC C1588
D601: B5819W; D_SOD-123; MPN B5819W; LCSC C8598
D602: BAV99; SOT-23; MPN BAV99,215; LCSC C2500
J601: B4B-XH-A; JST_XH_B4B-XH-A_1x04_P2.50mm_Vertical
J602: B3B-PH-K; JST_PH_B3B-PH-K_1x03_P2.00mm_Vertical
J603: B4B-PH-K; JST_PH_B4B-PH-K_1x04_P2.00mm_Vertical
JP601, JP602, JP603, JP604: closed; SolderJumper-2_P1.3mm_Bridged_RoundedPad1.0x1.5mm
JP605: open; SolderJumper-2_P1.3mm_Open_RoundedPad1.0x1.5mm
R601: 1k; R_0603_1608Metric; LCSC C21190
R602, R603: 10k; R_0603_1608Metric; LCSC C25804
R604, R605: 100R; R_0603_1608Metric; LCSC C22775
R606, R607: 4.7k; R_0603_1608Metric; LCSC C23162
R608, R609: 2.2k; R_0603_1608Metric; LCSC C4190
R610: 100k; R_0603_1608Metric; LCSC C25803
U601: SRV05-4; SOT-23-6; MPN SRV05-4; LCSC C7420376

Connections:
+3V3: A601.15 (VIO), C602.1, D602.2 (K), R602.2; also elsewhere on the board
DIAG4: A601.18 (DIAG), D601.2 (A)
DIAG_OR: D601.1 (K); also elsewhere on the board
DIR4: A601.8 (DIR); also elsewhere on the board
DRV4_CS: R601.1; also elsewhere on the board
DRV4_CSP: A601.4 (CS/UART), R601.2
DRV4_SCK: A601.3 (SCK/MS2), JP602.1 (A)
DRV4_SDI: A601.2 (SDI/MS1), JP601.1 (A)
DRV4_SDO: A601.5 (SDO), JP603.1 (A)
DRV_ENN: A601.1 (EN); also elsewhere on the board
GND: A601.10 (GND), A601.16 (GND), C601.2, C602.2, C603.2, D602.1 (A), J602.2 (GND), J603.2 (GND), R610.2, U601.2 (GND); also elsewhere on the board
HOME4: C603.1, D602.3 (COM), R603.2; also elsewhere on the board
HOME4_IN: J602.3 (HOME), R602.1, R603.1
M4_1: A601.11 (M1), J601.1
M4_2: A601.12 (M2), J601.2
M4_3: A601.13 (M3), J601.3
M4_4: A601.14 (M4), J601.4
MUX4_SCL: R605.1; also elsewhere on the board
MUX4_SDA: R604.1; also elsewhere on the board
PU4_A: JP604.1 (A), R606.2, R607.2
PU4_B: JP605.1 (A), R608.2, R609.2
SNS4_SCL: J603.4 (SCL), R605.2, R607.1, R609.1, U601.3 (IO2)
SNS4_SDA: J603.3 (SDA), R604.2, R606.1, R608.1, U601.1 (IO1)
SPI_MISO: JP603.2 (B); also elsewhere on the board
SPI_MOSI: JP601.2 (B); also elsewhere on the board
SPI_SCK: JP602.2 (B); also elsewhere on the board
STEP4: A601.7 (STEP), R610.1; also elsewhere on the board
VM: A601.9 (VM), C601.1; also elsewhere on the board
V_SNS: J602.1 (V), J603.1 (V), JP604.2 (B), JP605.2 (B), U601.5 (VCC); also elsewhere on the board

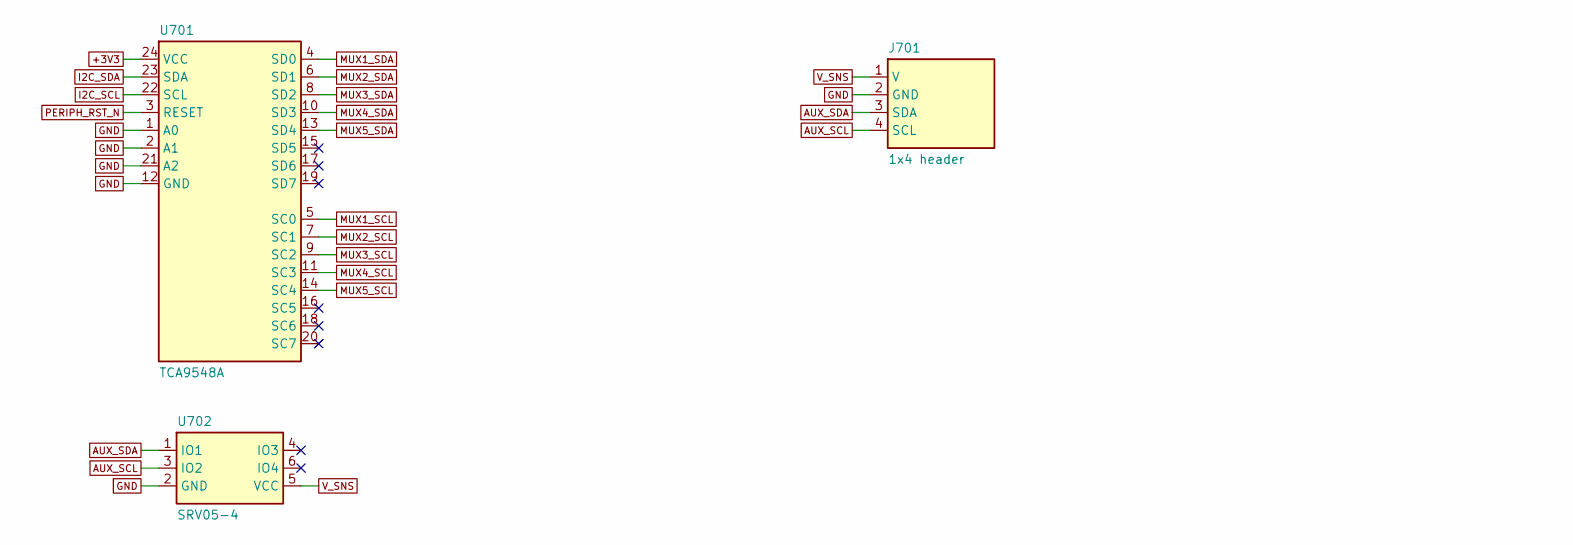
[picture p30: schematic sensors.kicad_sch, I2C multiplexer, ESD protection, spare port, part in row 1, column 1]

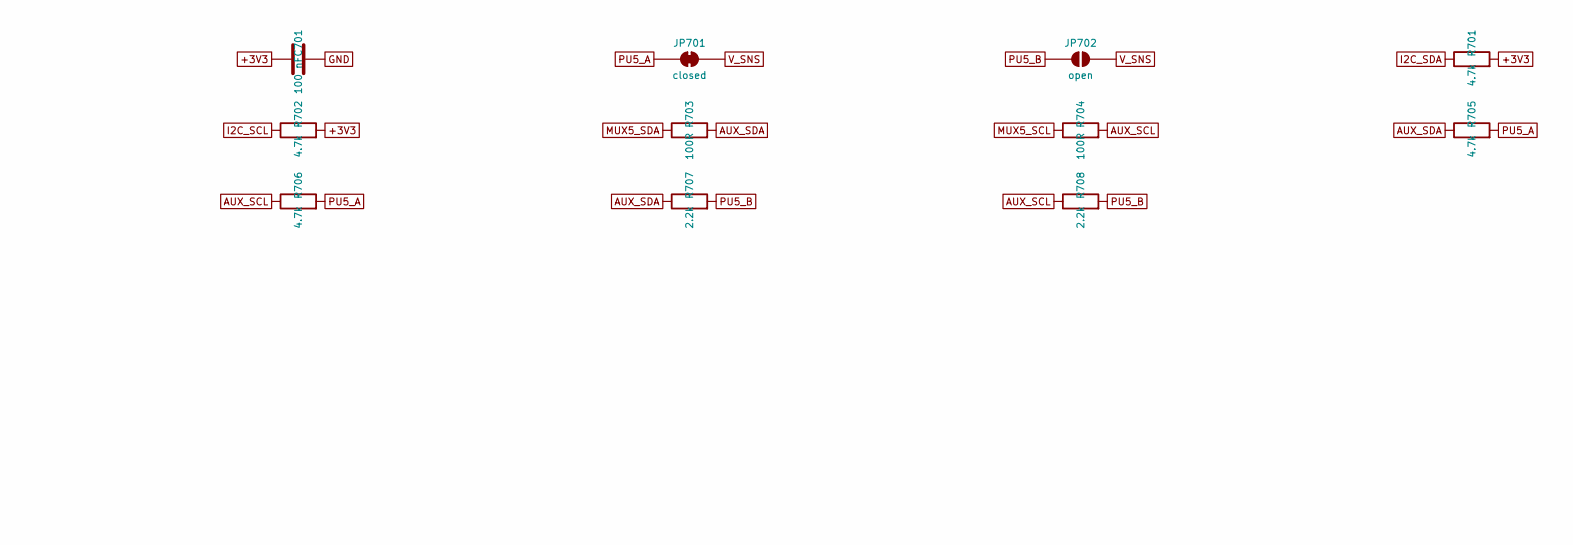
[picture p31: schematic sensors.kicad_sch, I2C multiplexer, ESD protection, spare port, part in row 1, column 2]

Parts:
C701: 100 nF; C_0603_1608Metric; LCSC C14663
J701: 1x4 header; PinHeader_1x04_P2.54mm_Vertical
JP701: closed; SolderJumper-2_P1.3mm_Bridged_RoundedPad1.0x1.5mm
JP702: open; SolderJumper-2_P1.3mm_Open_RoundedPad1.0x1.5mm
R701, R702, R705, R706: 4.7k; R_0603_1608Metric; LCSC C23162
R703, R704: 100R; R_0603_1608Metric; LCSC C22775
R707, R708: 2.2k; R_0603_1608Metric; LCSC C4190
U701: TCA9548A; TSSOP-24_4.4x7.8mm_P0.65mm; MPN TCA9548APWR; LCSC C130026
U702: SRV05-4; SOT-23-6; MPN SRV05-4; LCSC C7420376

Connections:
+3V3: C701.1, R701.2, R702.2, U701.24 (VCC); also elsewhere on the board
AUX_SCL: J701.4 (SCL), R704.2, R706.1, R708.1, U702.3 (IO2)
AUX_SDA: J701.3 (SDA), R703.2, R705.1, R707.1, U702.1 (IO1)
GND: C701.2, J701.2 (GND), U701.1 (A0), U701.2 (A1), U701.12 (GND), U701.21 (A2), U702.2 (GND); also elsewhere on the board
I2C_SCL: R702.1, U701.22 (SCL); also elsewhere on the board
I2C_SDA: R701.1, U701.23 (SDA); also elsewhere on the board
MUX1_SCL: U701.5 (SC0); also elsewhere on the board
MUX1_SDA: U701.4 (SD0); also elsewhere on the board
MUX2_SCL: U701.7 (SC1); also elsewhere on the board
MUX2_SDA: U701.6 (SD1); also elsewhere on the board
MUX3_SCL: U701.9 (SC2); also elsewhere on the board
MUX3_SDA: U701.8 (SD2); also elsewhere on the board
MUX4_SCL: U701.11 (SC3); also elsewhere on the board
MUX4_SDA: U701.10 (SD3); also elsewhere on the board
MUX5_SCL: R704.1, U701.14 (SC4)
MUX5_SDA: R703.1, U701.13 (SD4)
PERIPH_RST_N: U701.3 (RESET); also elsewhere on the board
PU5_A: JP701.1 (A), R705.2, R706.2
PU5_B: JP702.1 (A), R707.2, R708.2
V_SNS: J701.1 (V), JP701.2 (B), JP702.2 (B), U702.5 (VCC); also elsewhere on the board

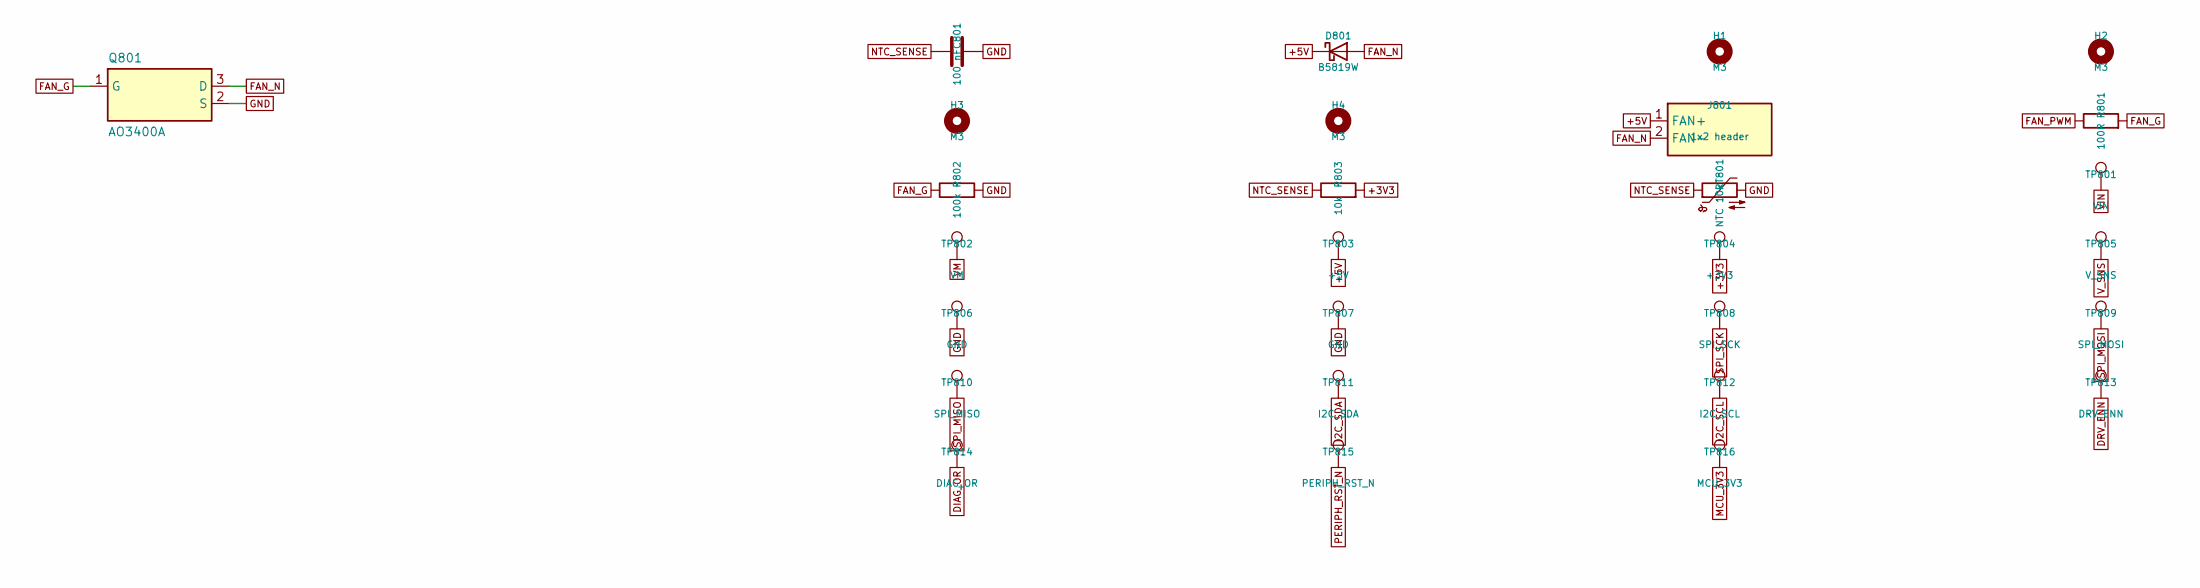
[picture p32: schematic io.kicad_sch, Fan output, board temperature, test points, mounting]

Parts:
C801: 100 nF; C_0603_1608Metric; LCSC C14663
D801: B5819W; D_SOD-123; MPN B5819W; LCSC C8598
H1, H2, H3, H4: M3; MountingHole_3.2mm_M3
J801: 1x2 header; PinHeader_1x02_P2.54mm_Vertical
Q801: AO3400A; SOT-23; MPN AO3400A; LCSC C20917
R801: 100R; R_0603_1608Metric; LCSC C22775
R802: 100k; R_0603_1608Metric; LCSC C25803
R803: 10k; R_0603_1608Metric; LCSC C25804
RT801: NTC 10k; R_0603_1608Metric; MPN KNTC0603/10KF3950; LCSC C2892547
TP801: VIN; TestPoint_D1.5
TP802: VM; TestPoint_D1.5
TP803: +5V; TestPoint_D1.5
TP804: +3V3; TestPoint_D1.5
TP805: V_SNS; TestPoint_D1.5
TP806, TP807: GND; TestPoint_D1.5
TP808: SPI_SCK; TestPoint_D1.5
TP809: SPI_MOSI; TestPoint_D1.5
TP810: SPI_MISO; TestPoint_D1.5
TP811: I2C_SDA; TestPoint_D1.5
TP812: I2C_SCL; TestPoint_D1.5
TP813: DRV_ENN; TestPoint_D1.5
TP814: DIAG_OR; TestPoint_D1.5
TP815: PERIPH_RST_N; TestPoint_D1.5
TP816: MCU_3V3; TestPoint_D1.5

Connections:
+3V3: R803.2, TP804.1; also elsewhere on the board
+5V: D801.1 (K), J801.1 (FAN+), TP803.1; also elsewhere on the board
DIAG_OR: TP814.1; also elsewhere on the board
DRV_ENN: TP813.1; also elsewhere on the board
FAN_G: Q801.1 (G), R801.2, R802.1
FAN_N: D801.2 (A), J801.2 (FAN-), Q801.3 (D)
FAN_PWM: R801.1; also elsewhere on the board
GND: C801.2, Q801.2 (S), R802.2, RT801.2, TP806.1, TP807.1; also elsewhere on the board
I2C_SCL: TP812.1; also elsewhere on the board
I2C_SDA: TP811.1; also elsewhere on the board
MCU_3V3: TP816.1; also elsewhere on the board
NTC_SENSE: C801.1, R803.1, RT801.1; also elsewhere on the board
PERIPH_RST_N: TP815.1; also elsewhere on the board
SPI_MISO: TP810.1; also elsewhere on the board
SPI_MOSI: TP809.1; also elsewhere on the board
SPI_SCK: TP808.1; also elsewhere on the board
VIN: TP801.1; also elsewhere on the board
VM: TP802.1; also elsewhere on the board
V_SNS: TP805.1; also elsewhere on the board
