Aottens/PTZ-DriverBoard/hardware/ptz-driver.kicad_pcb

## KiCad design hardware/ptz-driver.kicad_pcb (continued)

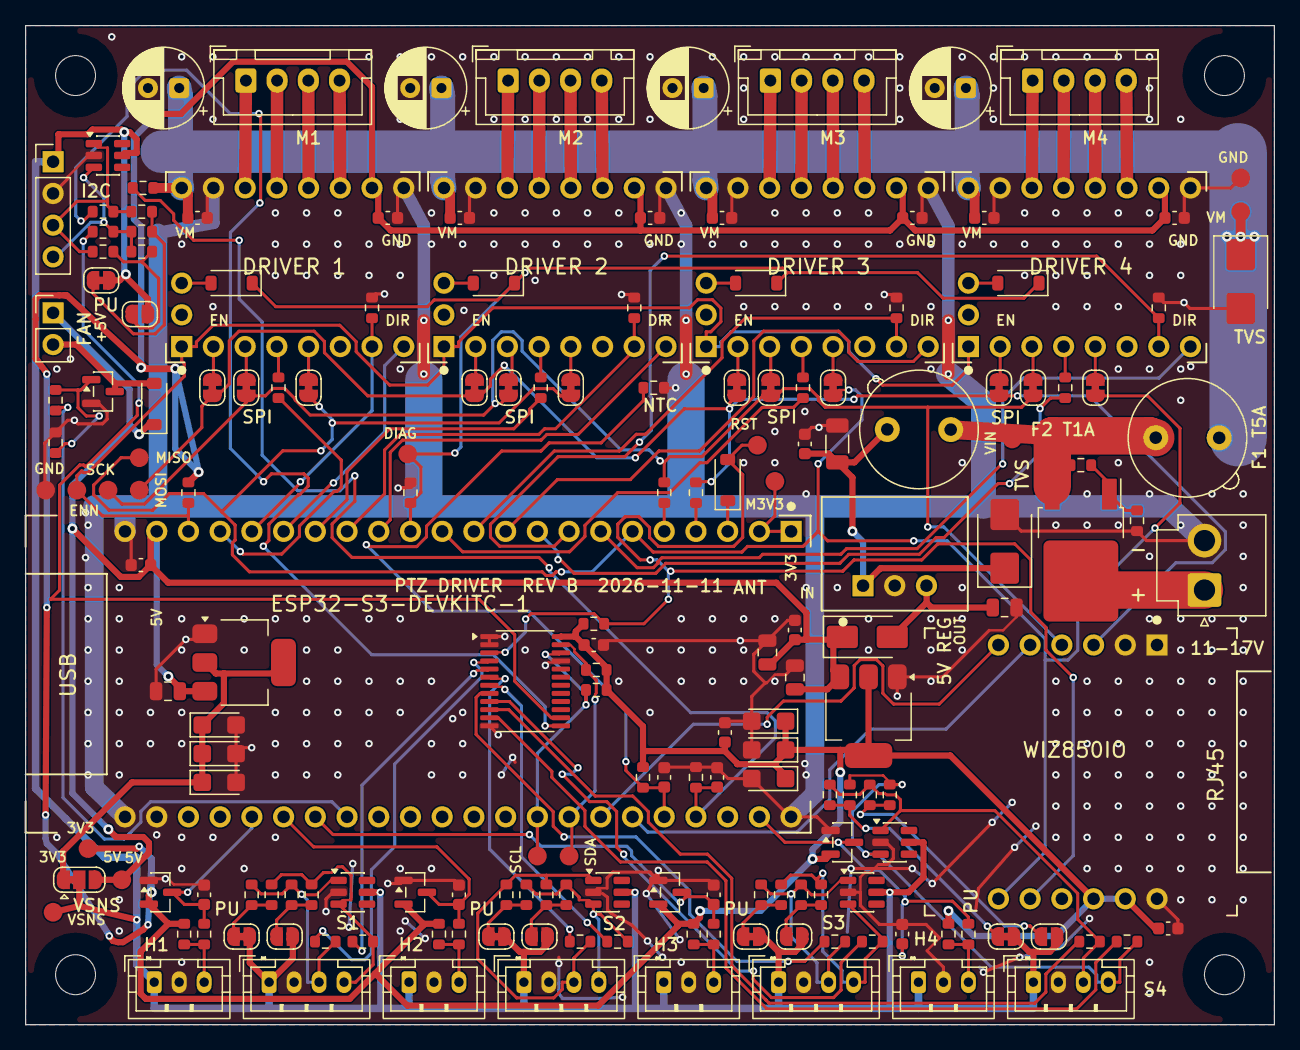
[picture p33: board ptz-driver.kicad_pcb from above]

Board: 2 copper layers, 100.0 x 80.0 mm, 186 parts (0 on the bottom side), 116 nets.
