Aottens/PTZ-DriverBoard/(commit log)

2026-11-04 harness: set up the project, tooling config and PRD draft (S0-01)
    Spec-driven loop from CMDMX and Kikkuh, KiCad flow from the scoreboard,
    earlier PTZ designs kept in docs/history for reference only.
2026-11-04 docs: add the research phase and the owner's choices (S0-02)
    The board is for one head and as small as possible, with four axes and a
    limited pan range. RS-232 is dropped. Part names become candidates until
    the research in docs/research closes (R-01..07, R-T1, R-T2).
2026-11-04 docs: set targets for theatre use and check the TMC5240 (R-01, R-03)
    The owner's use sets the targets: a camera up to 2 kg, among a theatre
    audience, as exact as DIY allows. The TMC5240 passes its datasheet check,
    including STEP and DIR output for an external driver. Adds the reduction
    question (R-08) and a one-axis test rig, since the old head stays out of it.
2026-11-04 docs: keep an optional fan output (AUX-03)
    Off by default. The head must still meet its targets without a fan.
2026-11-04 docs: approve the targets for the G7 and reopen the voltage (R-01)
    The targets are approved and the first camera is a G7 with a 14-140 mm.
    Real motor data shows the July motor needs 35 V at 30:1 and a 1 A motor
    9.7 V, so 12 V becomes a real option. The rig decides between them.
2026-11-04 spec: add the one-axis test rig (R-TR)
    One real pan axis with the real camera, before any board exists, to
    answer the motor, driver, sensor, voltage and reduction questions.
    Waits for owner approval (gate 1); no design or firmware yet.
2026-11-04 spec: approve the rig and fix its geometry and parts (R-TR)
    The owner approved the rig spec. Adds belt lengths, centres and layout,
    with a small script that checks them, and the parts list with shop prices.
2026-11-04 spec: lengthen rig belt B to 280 mm (R-TR)
    The 250 mm belt had 5.96 teeth in mesh, below the 6 that belts.py checks.
    The previous commit carried that failing check.
2026-11-04 mechanica: model the test rig in Fusion (R-TR)
    A generator script builds frame, pulleys and shaft, with bought parts for
    checking fit. No overlaps in either set-up. Adds the STL exports and the
    print list; tooth shape and fits are untested until a first print.
    [bearing_holder.stl, bearing_housing.stl, bottom_plate.stl, camera_plate.stl, foot.stl, magnet_holder.stl, output_shaft.stl, pillar.stl]
2026-11-04 mechanica: rebuild the rig for a single belt stage (R-TR, R-08)
    The owner rules out a double belt. The rig now compares 9:1 and 12.5:1
    on one motor slot, with 26 and 42 Ncm motors. Corrects the earlier case
    for 30:1, which counted absolute stepper error. Adds the capstan as a
    fallback idea. No print has tested the tooth shape or fits yet.
    [bearing_holder.stl, bearing_housing.stl, bottom_plate.stl, camera_plate.stl, foot.stl, output_shaft.stl, pillar.stl, pulley_200T.stl]
2026-11-04 mechanica: fit the rig to a base of 165 mm (R-TR, R-08)
    The owner rejected the size of a 200T and a 400 mm belt and set the base
    at 165 mm at most. The motor moves under the pulley, and the rig compares
    6.25:1 without idlers against 7.5:1 with two. Removes the old exports; the
    model still has to be rebuilt in Fusion.
    [bearing_housing.stl, bottom_plate.stl, camera_plate.stl, foot.stl, magnet_holder.stl, output_shaft.stl, pillar.stl, pulley_144T.stl]
2026-11-04 mechanica: export the rig for the 165 mm base (R-TR)
    Rebuilt in Fusion from build_rig.py, with no overlaps in either set-up.
    Nothing is printed yet, so tooth shape and fits are still untested.
    [bearing_housing.stl, bottom_plate.stl, camera_plate.stl, foot.stl, idler_spacer_low.stl, idler_spacer_top.stl, magnet_holder.stl, output_shaft.stl]
2026-11-04 mechanica: give the sensor tray legs (R-TR)
    The tray floated 5 mm under the plate: its spacers were never modelled or
    on the print list. Four legs now reach the plate, with shims for the gap.
    [rig.f3d, sensor_tray.stl]
2026-11-04 mechanica: make the rig buildable after review (R-TR)
    A blind review and a walk through the assembly found that the camera
    could not be fixed, the end stop fell short of 170 degrees, the hexagon's
    corners did not pass the bearings, and idler spacers would bind the bearings.
    All fixed in the script. Adds a print check, fit test prints and an
    assembly order. Still calculated only: nothing is printed or built.
    [bearing_housing.stl, bottom_plate.stl, camera_plate.stl, fit_seat.stl, fit_shaft.stl, idler_spacer_low.stl, idler_spacer_top.stl, output_shaft.stl]
2026-11-05 mechanica: add a script to rebuild the rig through Fusion (R-TR)
    The session's own Fusion connection fails when Fusion starts after it, so
    keep the steps in the repo: build, check and export over the local
    endpoint. Brings STATE up to date for the handoff.
    [fusion_rebuild.py]
2026-11-09 harness: add working rules for board design
    Schematic and layout go to the strongest model. Adds routing order,
    a provisional pin table, a housing fit check and sorted manufacturability
    flags, after Anthropic's electronics write-up. Approved by the owner.
2026-11-10 harness: prepare the one-run Rev A board build
    Add the approved Fable 5.2 prompt for Rev A and write the exceptions
    for this build into the rules that would stop it.
    Choose the ESP32-C6-MINI-1U (CTL-01), because JLC lists the ESP32-S3
    modules as Standard Only and Rev A uses Economic PCBA (BRD-02). Settle
    CTL-03, CAM-02, BRD-01 and BRD-04. Backlog row RA-01 covers S2-01 to
    S3-03. The order gate is unchanged.
2026-11-10 specs: add Rev A module specs and the single pin source (S2-01)
    Module specs for POW, DRV, ENC, CTL, CAM/AUX and BRD with numbered criteria,
    connection tables by datasheet pin name, and datasheet revisions.
    firmware/include/pins.h is the one place MCU and expander pins are assigned.
    Generator and netlist helpers for the KiCad schematic, and the JLC sourcing
    candidates read from jlcpcb.com/partdetail on 2026-11-10.
2026-11-10 hardware: add the Rev A schematic and its netlist check (S2-02 to S2-05)
    The schematic is generated by hardware/tools/circuit.py from the module specs
    and firmware/include/pins.h; LCSC number, value and footprint are fields on
    each symbol. hardware/check_netlist.py was written by a separate agent from
    the specs and datasheets without seeing the schematic: 40 criteria, 997 pins,
    0 mismatches. ERC through kicad-cli: 0 violations.
    Space on 85 x 65 mm ran out by area count, so per CTL-03 the RJ45 jack is
    replaced by a header (J801) for an off-board jack; motor, sensor, CAN and fan
    connectors are top entry.
    [axis1.kicad_sch, axis2.kicad_sch, axis3.kicad_sch, axis4.kicad_sch, buffers.kicad_sch, comms.kicad_sch, io.kicad_sch, mcu.kicad_sch]
2026-11-10 hardware: add calculations, fit check and bring-up checklist
    calc/power.py and calc/thermal.py hold every input with its source.
    Thermal result: four axes at 1.5 A continuously are too much in still air;
    the board gets bare ground windows under the drivers for a heat spreader
    (DRV-05, BRD-11). check_fit.py checks the board, its plugs and cable bends
    in the working envelope. First placement and board build tools.
    [axis1.kicad_sch, axis2.kicad_sch, axis3.kicad_sch, axis4.kicad_sch, ptz-driver.kicad_pcb]
2026-11-10 hardware: place the board and add the board tools
    tools/board.py builds the board from the netlist: fixed places for ICs and
    connectors (tools/placement.py), small parts next to the pad they belong to,
    planes, input pours, thermal vias and keep-outs. tools/silk.py names every
    connector and test point; fab/make_jlc.py fits each part onto JLC's own
    footprint (the DPAK got a footprint with JLC's land pattern). check_board.py
    checks the numbers in specs/modules/board.md. Not routed yet.
    [axis1.kicad_sch, axis2.kicad_sch, axis3.kicad_sch, axis4.kicad_sch, comms.kicad_sch, easyeda_cache.json, power.kicad_sch, ptz-driver.kicad_pcb]
2026-11-10 docs: describe Rev A in ARCHITECTURE and hardware/README, record JLC stock readings
    [comms.kicad_sch, ptz-driver.kicad_pcb]
2026-11-10 hardware: note where the Rev A build paused and how to resume
    [rev-a.dsn, rev-a_input.kicad_pcb]
2026-11-10 hardware: widen every net class after routing, add Gerber script and review brief
2026-11-10 hardware: tie supply pads to their planes before routing, add a completion router
    Freerouting left the GND, +3V3 and VM pads off the inner planes once the top layer was full.
    tools/complete.py fanout now gives each of those pads a short track and a via on the placed board,
    and the DSN export marks them as protected. The same grid router closes what Freerouting leaves
    open afterwards, working from KiCad's DRC report. The VM plane ends under the drivers' VS pins,
    with two tongues to the bulk capacitors, so +3V3 lies under the drivers' logic side (BRD-03, BRD-06).
    [board.py, complete.py, placement.py]
2026-11-10 hardware: route the hard nets before Freerouting, open inner layer 2 for signals
    tools/complete.py fanout now lays, on the placed board and in this order: the motor outputs
    (BRD-06), every pad pair of one net within 3 mm, the VM pads' vias, the drivers' SPI bus as
    three straight bottom-layer lines with a via per pin, and the GND and +3V3 pads' vias. The DSN
    marks all of it as protected. Freerouting then routes the rest and may use inner layer 2
    outside a keep-out over the VM plane; BRD-03 and its check say so. The home input's filter
    moved under the driver's corner to free the strip the bus pins need.
2026-11-10 hardware: note where routing paused, add escape vias and a fill-aware plane test
    The board is not routed yet. BUILD_NOTES records the state, what the last change broke
    (the escape via of pin 26 blocks the SPI_SCK pin's way to its bus line) and how to resume.
    [complete.py]
2026-11-10 hardware: grow the board to 100 x 80 mm, lay the hard nets before routing (BRD-01, BRD-04)
    Owner's decision of 2026-11-10: the board lies in the base, so it may be 100 x 80 mm; the RJ45
    jack and the supply inlet sit in the base wall. Placement, plane split, checks and the review
    brief follow. The pre-routes in tools/complete.py now reserve the drivers' bus lines first,
    tie IC supply pins before local tracks, and give each driver's own signals an escape via over
    the +3V3 plane; the completion router can push a signal track out and lay it again.
2026-11-10 hardware: keep pre-routes fixed when pushing, stop local tracks fencing in IC pins
    The completion router recognises the tracks laid before routing by their place and leaves them
    alone; it searches more greedily, so long connections across the board find their way through
    inner layer 2. Before routing, all GND and +3V3 pads get their via before the local
    connections are laid, and two pins of one IC are no longer joined along their row.
    [complete.py]
2026-11-10 hardware: fan out IC pins without fencing them in, keep escape stubs until the end
    Local connections before routing now join an IC pin to the part that belongs to it only; the
    bus nets get escape vias on every IC but the drivers; escape stubs elsewhere stay under 1.6 mm.
    The cleaning between rounds leaves unused pre-routes alone, and 'complete.py prune' removes
    them at the end. Tracks taken off the board stay in memory until the script ends: freeing
    them broke KiCad's net list under Python.
    [complete.py]
2026-11-10 hardware: route Rev A to zero DRC violations and zero unconnected (BRD-03, BRD-05, BRD-06, BRD-10)
    complete.py: a net's own via is a free layer change, a connection is searched from
    any copper of one piece of the net to any copper of the other, signals go before
    plane ties, and a last try may also move pushed nets and pre-routed stubs. An
    unplated hole keeps 0.25 mm.
    board.py: long narrow supply and motor tracks are cut into pieces before widening,
    in two passes so neighbours share the room; a rerun of finish no longer crashes.
    placement.py: C804 and C808 change places (U801 pins 20 to 22 reach their
    capacitors without crossing); C201 and the four IREF resistors move off their
    neighbour's pi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
    [ptz-driver.kicad_pcb, rev-a.dsn, rev-a_input.kicad_pcb]
2026-11-10 hardware: add JLC BOM, placement file, Gerbers and the sourcing table for the routed board (BRD-02)
    make_jlc.py: 251 parts on 84 BOM lines, every part fitted on JLC's own footprint
    within 0.35 mm. jlc_read.py: 42 Basic and 42 Extended lines, none Standard Only.
    [easyeda_cache.json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]
2026-11-10 docs: bring build notes, assembly notes and the hardware README up to the routed 100 x 80 mm board
    BUILD_NOTES: lessons 16 to 23 and the steps that made the routed board, including
    what was done by hand. ASSEMBLY: USB-C socket 29 mm from the wall (check_fit.py),
    heat windows 17.0 mm apart. Renders of both sides for the bring-up checklist.
2026-11-10 hardware: handle the blind review: 3.3 V output, crystal nets, bulk capacitor vias, chip-select resistors
    B1: the 3.3 V regulator output goes to the plane through six vias and 0.5 mm
    tracks instead of one via and 0.2 mm (placement.MORE_VIAS, board.WIDE_NETS).
    B2: ETH_XI runs on the top layer only, 2.4 mm from pin to crystal; the +3V3 track
    between the crystal's pads is gone; ETH_XO is down from about 36 mm and five vias
    to about 22 mm and three.
    K1: each 220 uF capacitor has three vias per pad instead of one.
    K5: the sensor chip-select series resistors are 100 ohm instead of 33 (ENC-06):
    a short to ground stays under the decoder's 50 mA.
    complete.py: 'more' adds plane vias, a round removes d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
    [axis1.kicad_sch, axis2.kicad_sch, axis3.kicad_sch, axis4.kicad_sch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]
2026-11-10 docs: record what was done with each blind review finding (DECISIONS, review/HANDLED, ENC-05, bring-up)
    B3, B4 and B5 and the rest of B2 are accepted in DECISIONS.md with a reversal
    trigger each. sensing.md ENC-05 states the limit of the sensor ports (clock
    resting low). The bring-up checklist gains 0.3b (TVS direction before power),
    5.2b (sensor SPI mode) and 7.1b (Ethernet under a running motor).
2026-11-10 docs: close the Rev A build: second review, STATE, BACKLOG and README (RA-01, S2-01 to S3-03)
    The second look after the fixes says the board can be ordered; its small findings
    are in hardware/review/HANDLED.md. From it: the ground via under R601 moved off
    the pad, and make_jlc.py writes one BOM line per part number (80 lines).
    BACKLOG: RA-01 and S2-01 to S3-03 done, RB-01 added. STATE and README rewritten.
    Checks after the last board change: DRC 0 violations, 0 unconnected, 0 parity;
    check_board 0 failures; check_netlist 963 pins, 0 mismatches; check_fit 0 failures.
    [ptz-driver-B_Cu.gbl, ptz-driver-B_Mask.gbs, ptz-driver-B_Silkscreen.gbo, ptz-driver-Edge_Cuts.gm1, ptz-driver-F_Cu.gtl, ptz-driver-F_Mask.gts, ptz-driver-F_Paste.gtp, ptz-driver-F_Silkscreen.gto]
2026-11-11 spec: approve Rev B and prepare its one-run build (RB-01)
    Rewrite the PRD for Rev B: plug-in StepStick drivers, an
    ESP32-S3-DevKitC-1U, a W5500 module and I2C sensor ports behind a
    multiplexer, at most EUR 100 per JLC order of five (COST-01..03).
    Strike RS-485, CAN and tally; input 11 to 17 V for D-Tap.
    Add ENC-06: presets after a restart, measured on the rig (R-T2).
    Add the cost estimate and the Fable 5.2 prompt for RB-02, which
    reuses the Rev A tools. Widen the one-run build exceptions in
    CLAUDE.md from Rev A to Rev B.
2026-11-11 spec: write the Rev B module specs, pin table and cost estimate (RB-02)
    Rev B replaces Rev A in place; Rev A is under the tag rev-a.
    Criteria: POW-01..09, DRV-01..10, ENC-01..08, CTL-01..09, AUX-01..06, BRD-01..12.
    The cost estimate is redone from the planned parts list before the schematic
    (COST-03): EUR 59 to 75 for five boards, three Extended lines.
    [planned_bom.csv]
2026-11-11 hardware: Rev B schematic, placement and routed two-layer board (RB-02)
    The circuit is generated from tools/circuit.py and firmware/include/pins.h;
    check_netlist.py was written by a separate agent from the specs alone and
    agrees on 536 pins. Placement is data in tools/placement.py; the supply path
    is laid as tracks and pours of a known width, Freerouting routes the rest and
    tools/complete.py closes what it leaves open and stitches the ground pours.
    DRC through kicad-cli: 0 violations, 0 unconnected, 0 parity issues. ERC: 0.
    Criteria: POW-01..08, DRV-01..08, ENC-01..08, CTL-01..09, AUX-03..06, BRD-10.
    [axis1.kicad_sch, axis2.kicad_sch, axis3.kicad_sch, axis4.kicad_sch, buffers.kicad_sch, comms.kicad_sch, easyeda_cache.json, io.kicad_sch]
2026-11-11 hardware: Rev B checks, calculations, JLC files and review brief (RB-02)
    check_board.py and check_fit.py are rewritten for the two-layer carrier and
    its modules; calc/power.py holds the margins at 17 V, the hot-plug and the
    supply budget; fab/ has the BOM and placement file fitted on JLC's own
    footprints, JLC's pin names against the board's nets, and the Gerbers.
    All 24 assembled lines are Economic and Standard; three are Extended.
    Criteria: POW-02, POW-04, POW-09, DRV-09, BRD-01..12.
    [easyeda_cache.json, easyeda_pins.json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]
2026-11-11 docs: Rev B assembly, bring-up checklist, build notes and tracking (RB-02)
    ASSEMBLY.md lists what the owner buys, solders and plugs; the bring-up
    checklist powers the board up section by section; BUILD_NOTES.md gains the
    Rev B lessons; DECISIONS, STATE, BACKLOG, README and ARCHITECTURE follow.
    The cost estimate is redone from the real BOM: EUR 62 to 78 (COST-03).
2026-11-11 hardware: fix what the blind review of Rev B found (RB-02)
    The first blind review (hardware/review/BLIND_REVIEW.md) gave no KRITIEK
    and three BELANGRIJK findings. All three are fixed, with four small ones:
    - BRD-11: nothing stands under the soldered-in Ethernet module; port 4's
    ESD array, pull-ups and clamp moved west of it. check_board.py checks it.
    - AUX-03: the fan output is 5 V only; the jumper to VM is gone.
    - POW-07, POW-08: capacitance on the logic rails cut from about 320 uF to
    113 uF (C201, C203 removed; three 10 uF tantalums per regulator). The
    sum with the modules is in calc/power.py; the Traco TSR 1-2450 and the
    Mornsun K7805-1000R3 take it, the RECOM R-78E does not and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
    [axis1.kicad_sch, axis2.kicad_sch, axis3.kicad_sch, axis4.kicad_sch, easyeda_cache.json, easyeda_pins.json, io.kicad_sch, mcu.kicad_sch]
2026-11-11 hardware: fix what the second blind review found (RB-02)
    The second blind review (hardware/review/BLIND_REVIEW_2.md) looked at the
    board after the first round of fixes: no KRITIEK, three BELANGRIJK.
    - BRD-13 (new): ground between the driver half and the rest. Signal tracks
    cut both pours across the board, leaving 4.2 mm of ground copper. A
    ground spine and four bridges are now laid as tracks before routing, and
    the VM test point moved off the east edge. tools/groundcut.py measures
    the narrowest cross-section (max-flow on a raster of the copper):
    14.0 mm to J101 pin 2 and 10.0 mm to the MCU module's ground pins;
    check_board.py asks 8.
    - POW-02: D103, a second SMBJ18A, clamps VIN_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
    [power.kicad_sch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]
2026-11-11 docs: record both blind reviews of Rev B and what was done (RB-02)
    hardware/review/HANDLED.md lists every finding of both reviews; DECISIONS
    has the reason for each accepted one. ASSEMBLY names the two 5 V modules
    that take the board's capacitance (not the R-78E), the 5 V-only fan
    output, and what the base must give the Ethernet plug. The bring-up
    checklist follows the changed parts. BUILD_NOTES gains lessons 41 to 52.
    The cost estimate from the final BOM is EUR 63 to 80 (COST-03).
2026-11-11 sourcing: add the owner's shopping list with LCSC numbers (RB-06)
    BRD-08: sourcing/owner_bom.py makes the list of everything JLC does not
    assemble from the schematic (parts without an LCSC field), with the
    mating plug, crimp contacts or socket for each, and stops when a part has
    no entry. Stock, minimum quantity and price come from LCSC's product
    endpoint. owner_bom_lcsc.csv is for LCSC's BOM tool: 19 lines, 17.76 USD
    for one board before shipping and tax. owner_bom.md also lists what LCSC
    does not have (MCU and driver modules, the 5 V regulator, sensor boards).
    [owner_bom_lcsc.csv]
2026-11-11 sourcing: put a 5 V regulator from LCSC on the shopping list (RB-07)
    The Traco TSR 1-2450 was the only DigiKey line: EUR 5.57 + VAT with EUR 18
    shipping below EUR 50. YLPTEC's K7805-1000R3 (LCSC C2992391, $2.38, in
    stock) comes with the LCSC order instead; the list orders two.
    POW-07: its data sheet V1.00 06/2013 gives pins 1 = in, 2 = ground, 3 = out,
    8 to 36 V in, 1 A, 680 uF capacitive load, 11.5 x 7.55 x 10.2 mm.
    calc/power.py lists it beside the Traco and the Mornsun. The spec says what
    the sheet leaves out and that nothing is measured. BRD-08: owner_bom.md and
    the CSV are regenerated, 20 LCSC lines.
    [owner_bom_lcsc.csv]
2026-11-11 sourcing: buy the loose parts at Reichelt, inside the EU (RB-08)
    The owner's LCSC cart showed about EUR 22 of import charges on USD 22.51 of
    parts: since July 2026 a parcel from outside the EU pays EUR 3 of duty per
    kind of product, with handling on top.
    BRD-08: owner_bom.py now lists 17 lines at Reichelt with article numbers
    and prices read on its Dutch pages, EUR 22.25 and EUR 6.95 shipping, and
    four female headers 1x40 at TinyTronics for the sockets. The LCSC cache and
    CSV are gone; owner_bom_reichelt.csv has article and quantity per line.
    POW-07: the regulator on the list is the Traco TSR 1-2450 again, which
    comes with the Reichelt order; the YLPTEC part stays named in the spec.
    BRD-12: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
    [owner_bom_lcsc.csv, owner_bom_reichelt.csv]
2026-11-12 review: handle the third blind review of Rev B (RB-09)
    A fresh reviewer saw the board as it is ordered, the one routed again
    after the second review: verdict order, no KRITIEK, one BELANGRIJK,
    nine KLEIN. Nothing on the board or in the JLC files changes.
    - hardware/review/BLIND_REVIEW_3.md as the reviewer wrote it, and a
    third table in HANDLED.md.
    - DECISIONS.md: SLEEPN of the TMC2240 modules on USB alone (K6) and
    the home inputs without a TVS array (K8, ENC-03) accepted; the
    placement point of asymmetric parts (K5) answered by calculation.
    - ASSEMBLY.md: the DevKit's row spacing (K4). Bring-up 7.9: VM on USB
    alone with four modules in (POW-05, POW-06).
    - BRD-10 and BRD-02 are uncha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
